baobuibk/NANORACK_V2_EXP_1.1.1_HW/02_Schematic_pdf/EXP_HW_V120.pdf

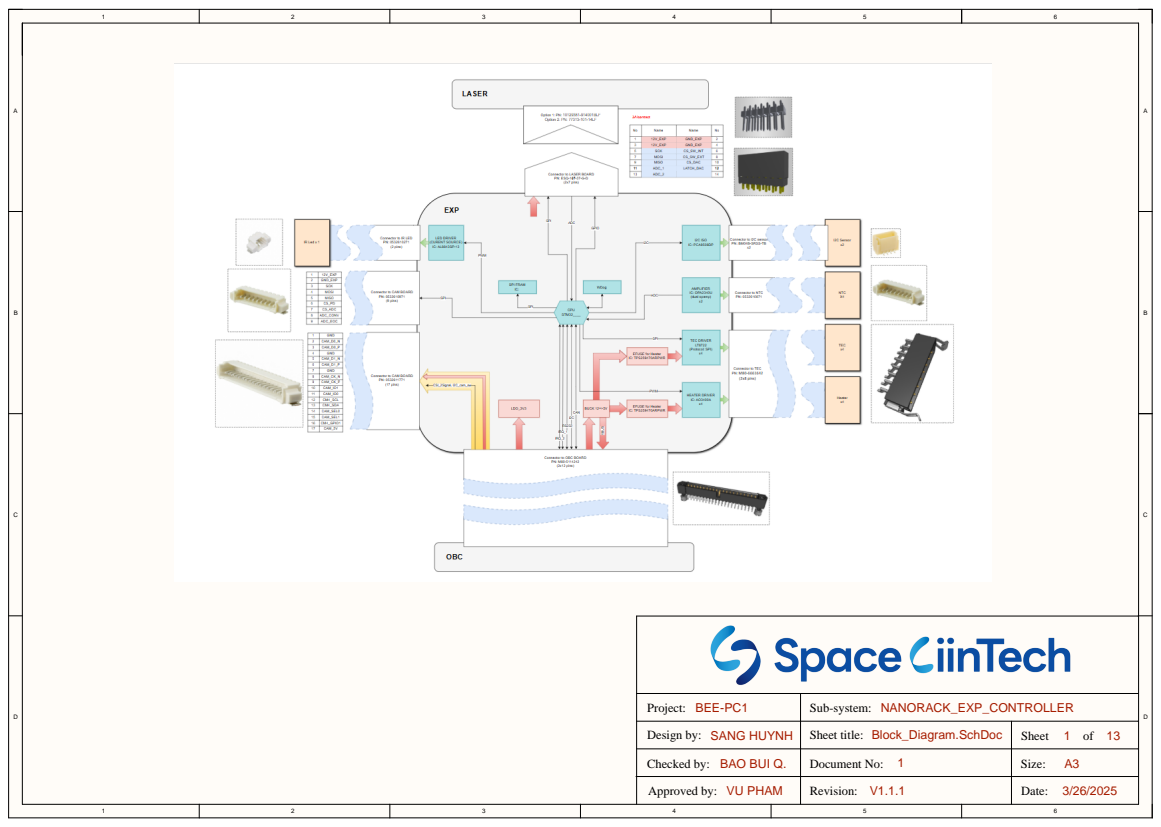
[picture p1: page 1]

Project: BEE-PC1 | Sub-system: NANORACK_EXP_CONTROLLER

Design by: SANG HUYNH | Sheet title: Block_Diagram.SchDoc | Sheet 1 of 13

Checked by: BAO BUI Q. | Document No: 1 | Size: A3

Approved by: VU PHAM | Revision: V1.1.1 | Date: 3/26/2025

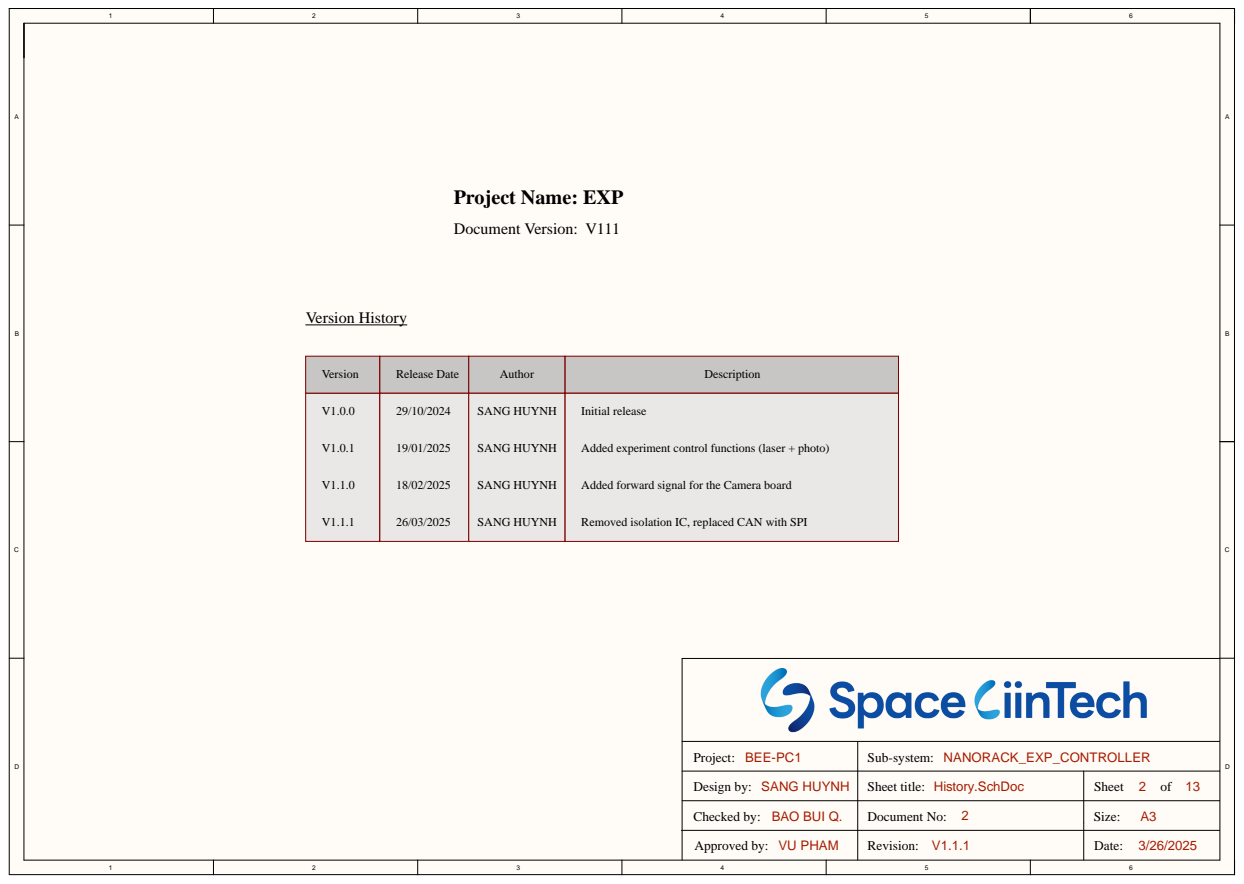
[picture p2: page 2]

Version | Release Date | Author | Description

V1.0.0 V1.0.1 V1.1.0 V1.1.1 | 29/10/2024 19/01/2025 18/02/2025 26/03/2025 | SANG HUYNH SANG HUYNH | Initial release Added experiment control functions (laser + photo) Added forward signal for the Camera board Removed isolation IC, replaced CAN with SPI

Project: BEE-PC1 | Sub-system: NANORACK_EXP_CONTROLLER

Design by: SANG HUYNH | Sheet title: History.SchDoc | Sheet 2 of 13

Checked by: BAO BUI Q. | Document No: 2 | Size: A3

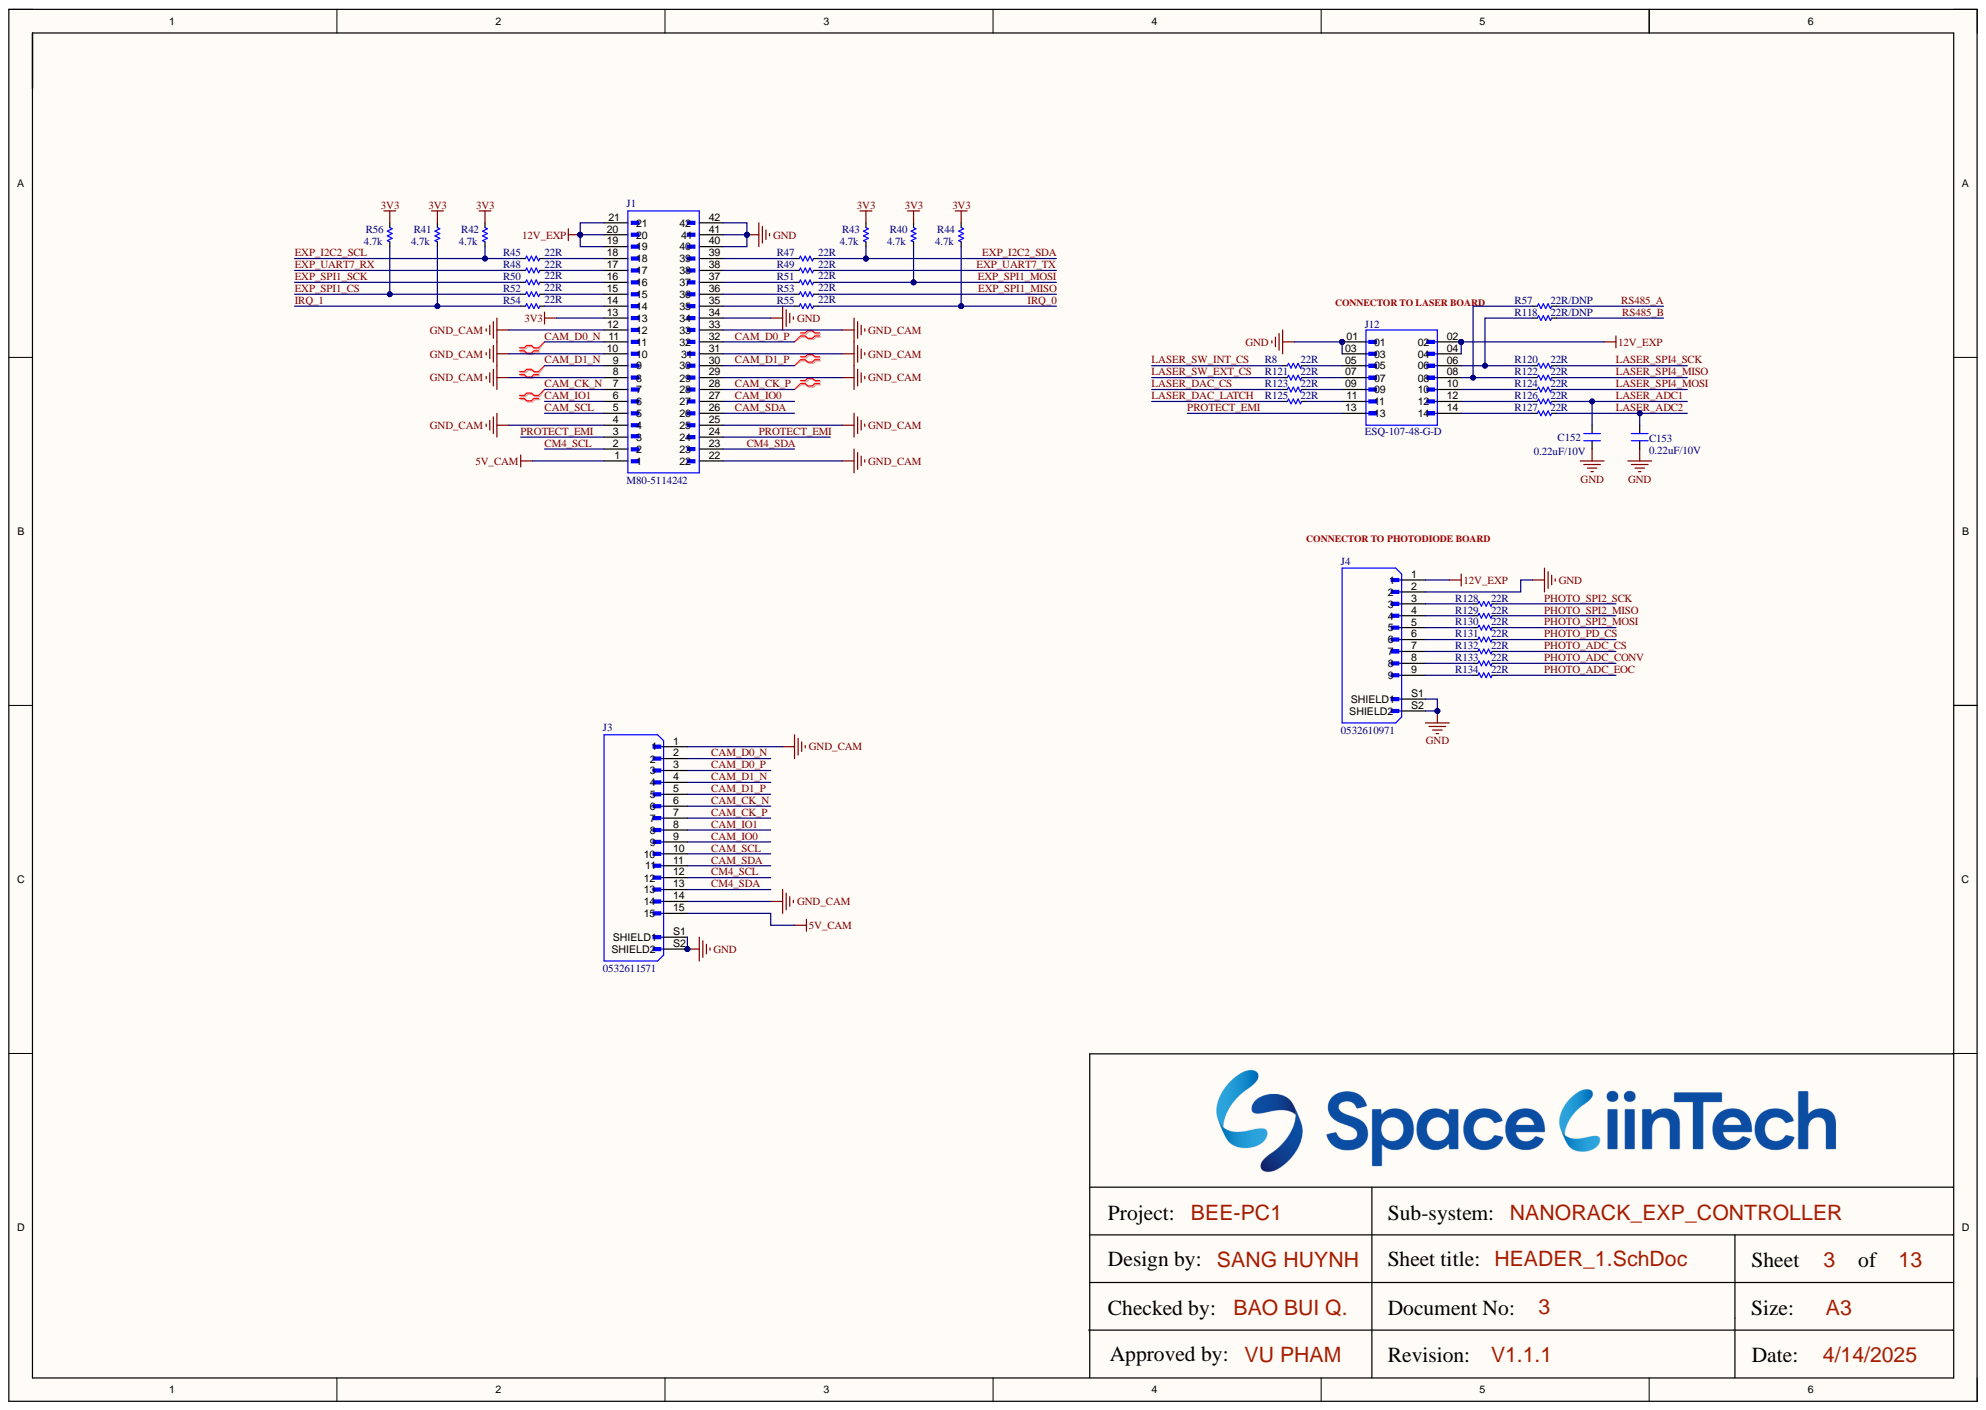
[picture p3: page 3]

CONNECTOR TO LASER BOARD

CONNECTOR TO PHOTODIODE BOARD

Project: BEE-PC1 | Sub-system: NANORACK_EXP_CONTROLLER

Design by: SANG HUYNH | Sheet title: HEADER_1.SchDoc | Sheet 3 of 13

Checked by: BAO BUI Q. | Document No: 3 | Size: A3

Date: 4/14/2025

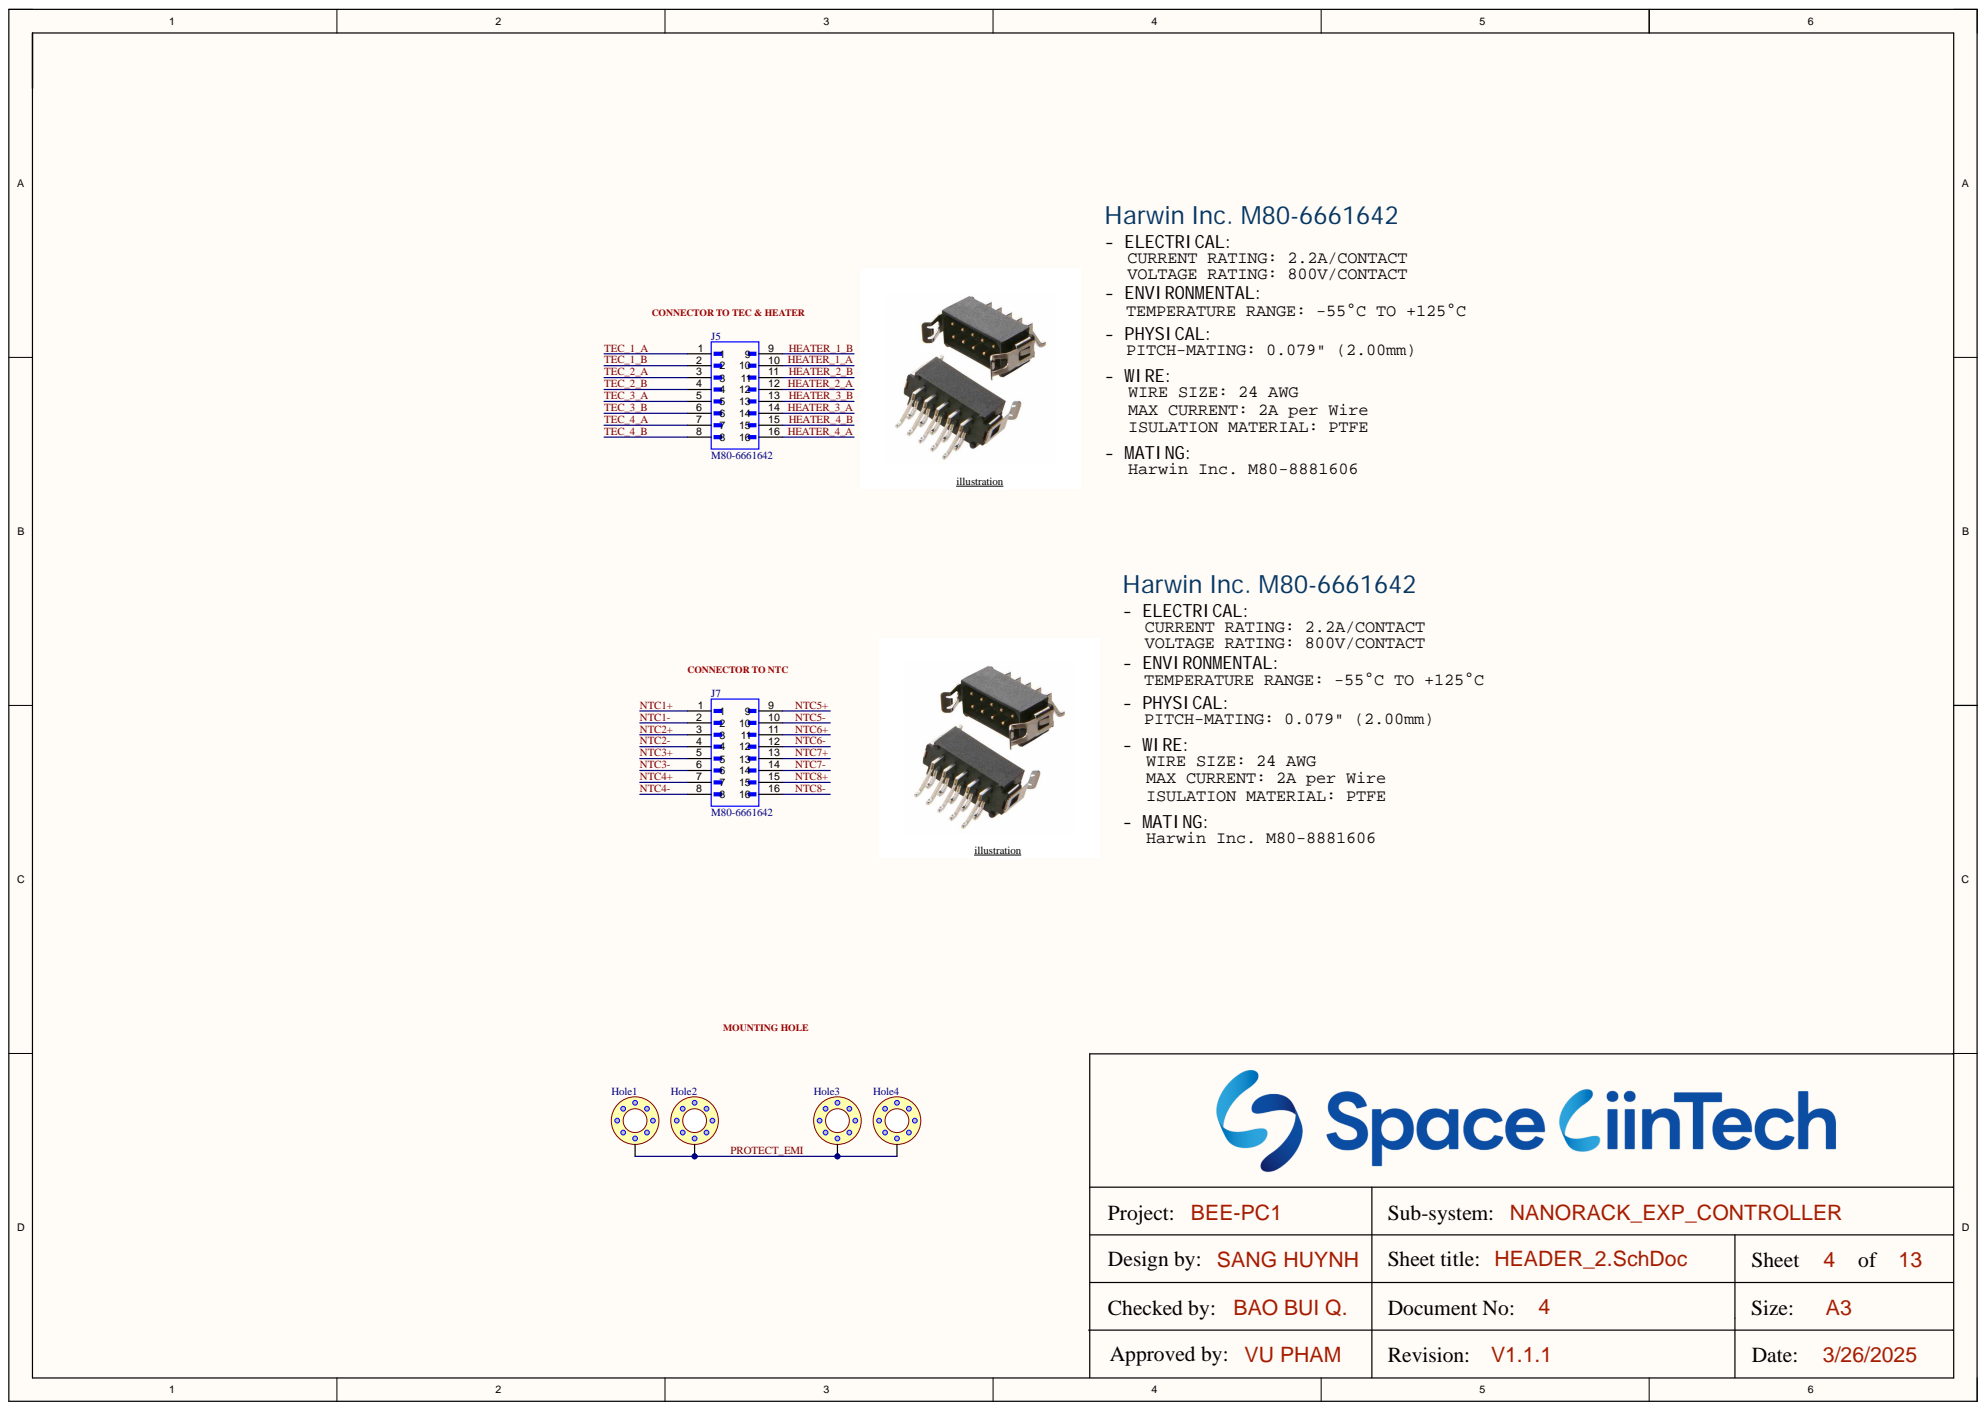
[picture p4: page 4]

- ELECTRICAL: CURRENT RATING: 2.2A/CONTACT VOLTAGE RATING: 800V/CONTACT

- ENVIRONMENTAL: TEMPERATURE RANGE: -55°C TO +125°C

CONNECTOR TO TEC & HEATER

- WIRE:
WIRE SIZE: 24 AWG
MAX CURRENT: 2A per Wire
ISULATION MATERIAL: PTFE
- MATING:
Harwin Inc. M80-8881606

Project: BEE-PC1 | Sub-system: NANORACK_EXP_CONTROLLER

Design by: SANG HUYNH | Sheet title: HEADER_2.SchDoc | Sheet 4 of 13

Checked by: BAO BUI Q. | Document No: 4 | Size: A3

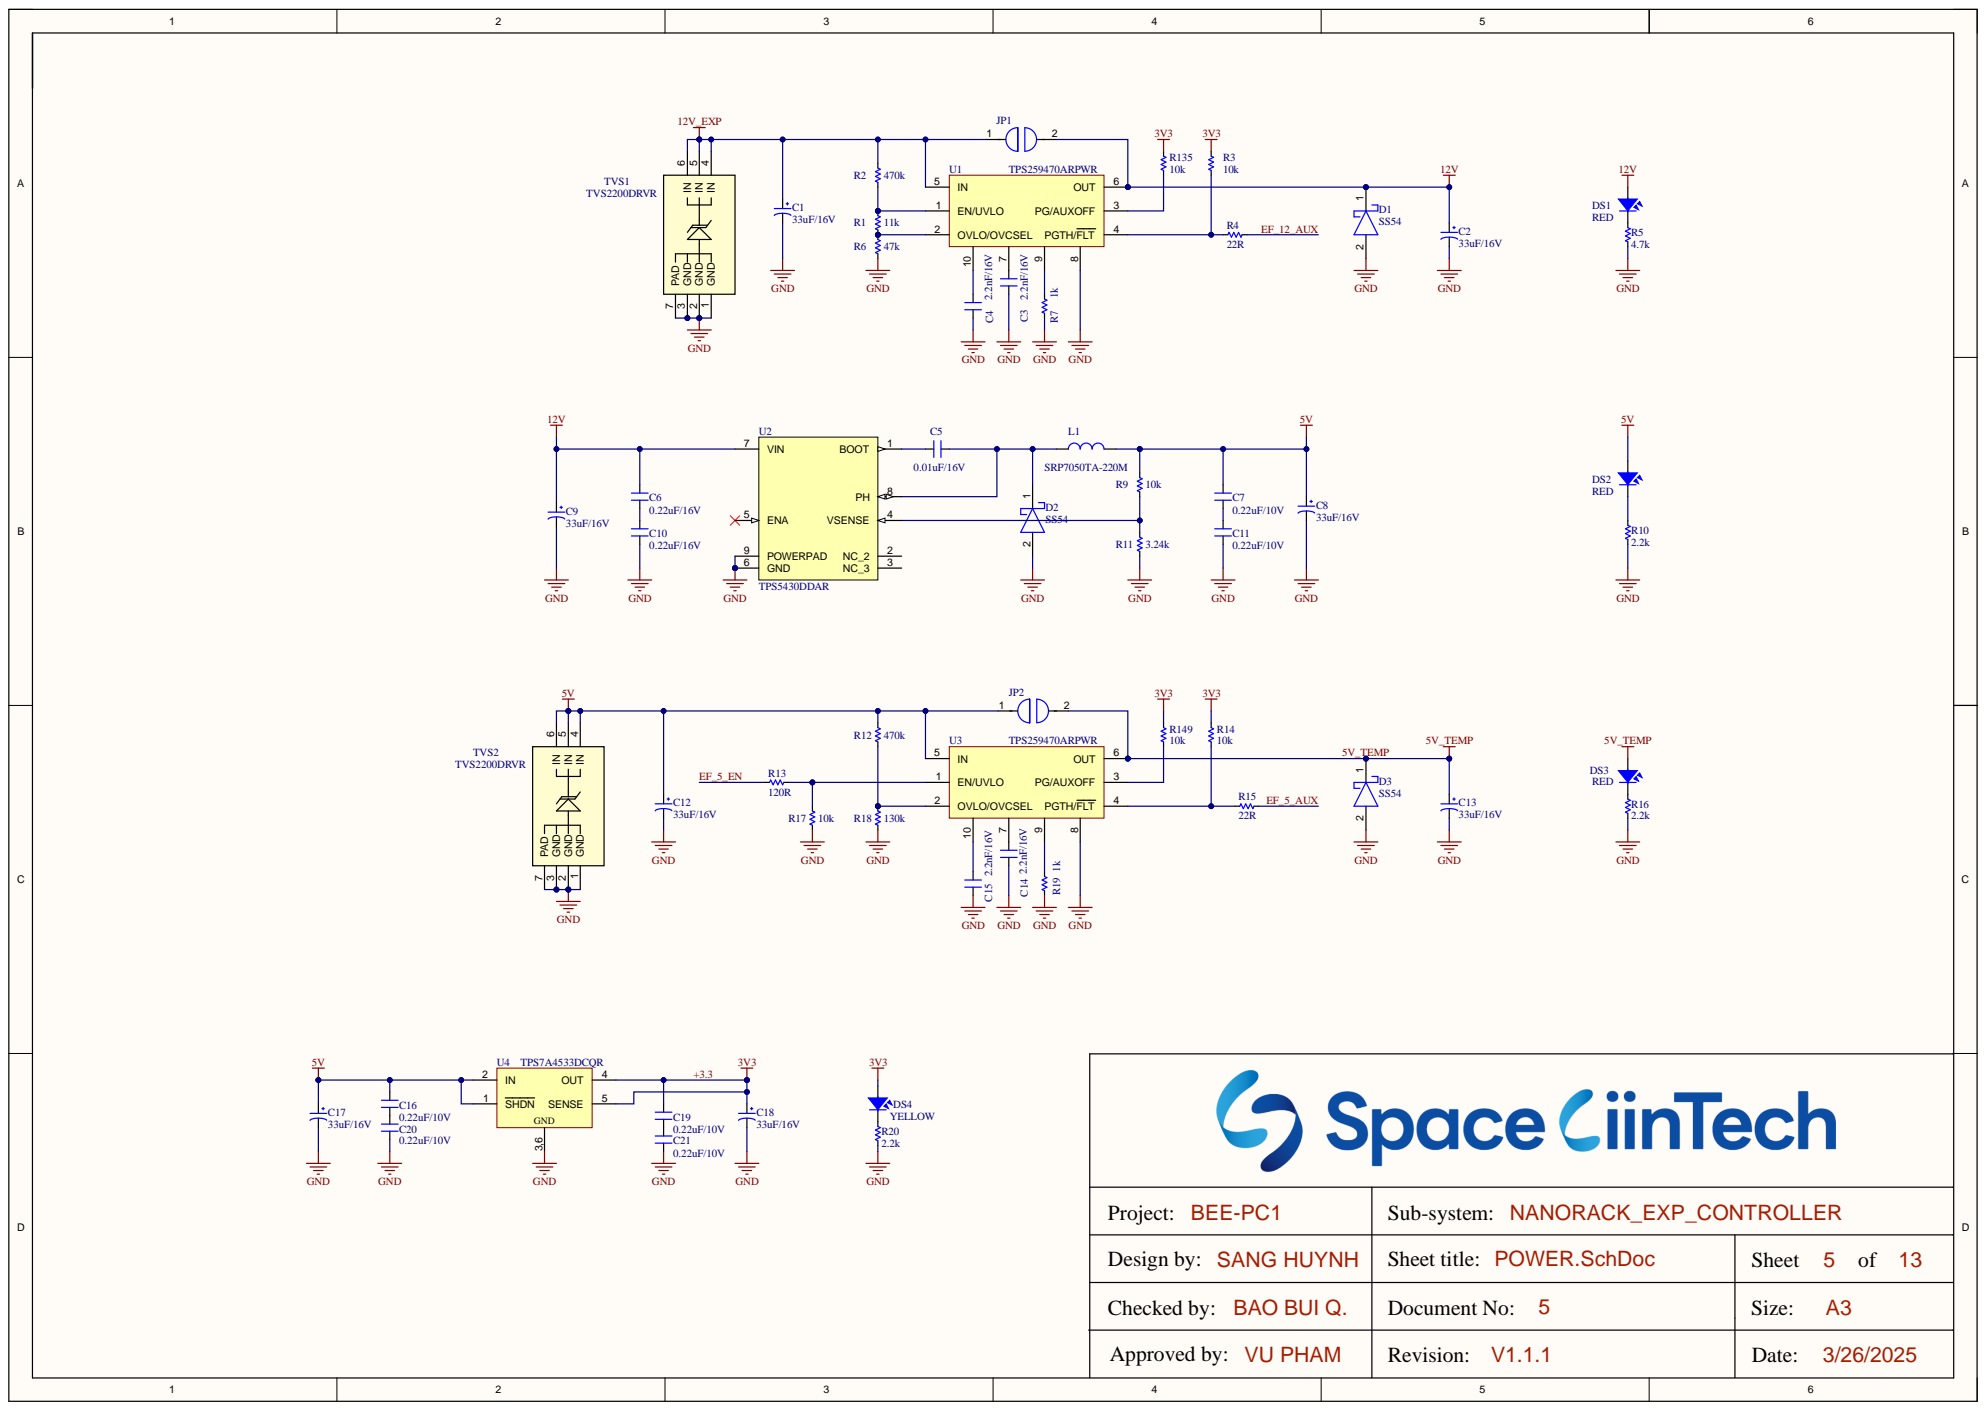
[picture p5: page 5]

IN 4 IN 5 IN 6 PAD 7

Project: BEE-PC1 | Sub-system: NANORACK_EXP_CONTROLLER

Design by: SANG HUYNH | Sheet title: POWER.SchDoc | Sheet 5 of 13

Checked by: BAO BUI Q. | Document No: 5 | Size: A3

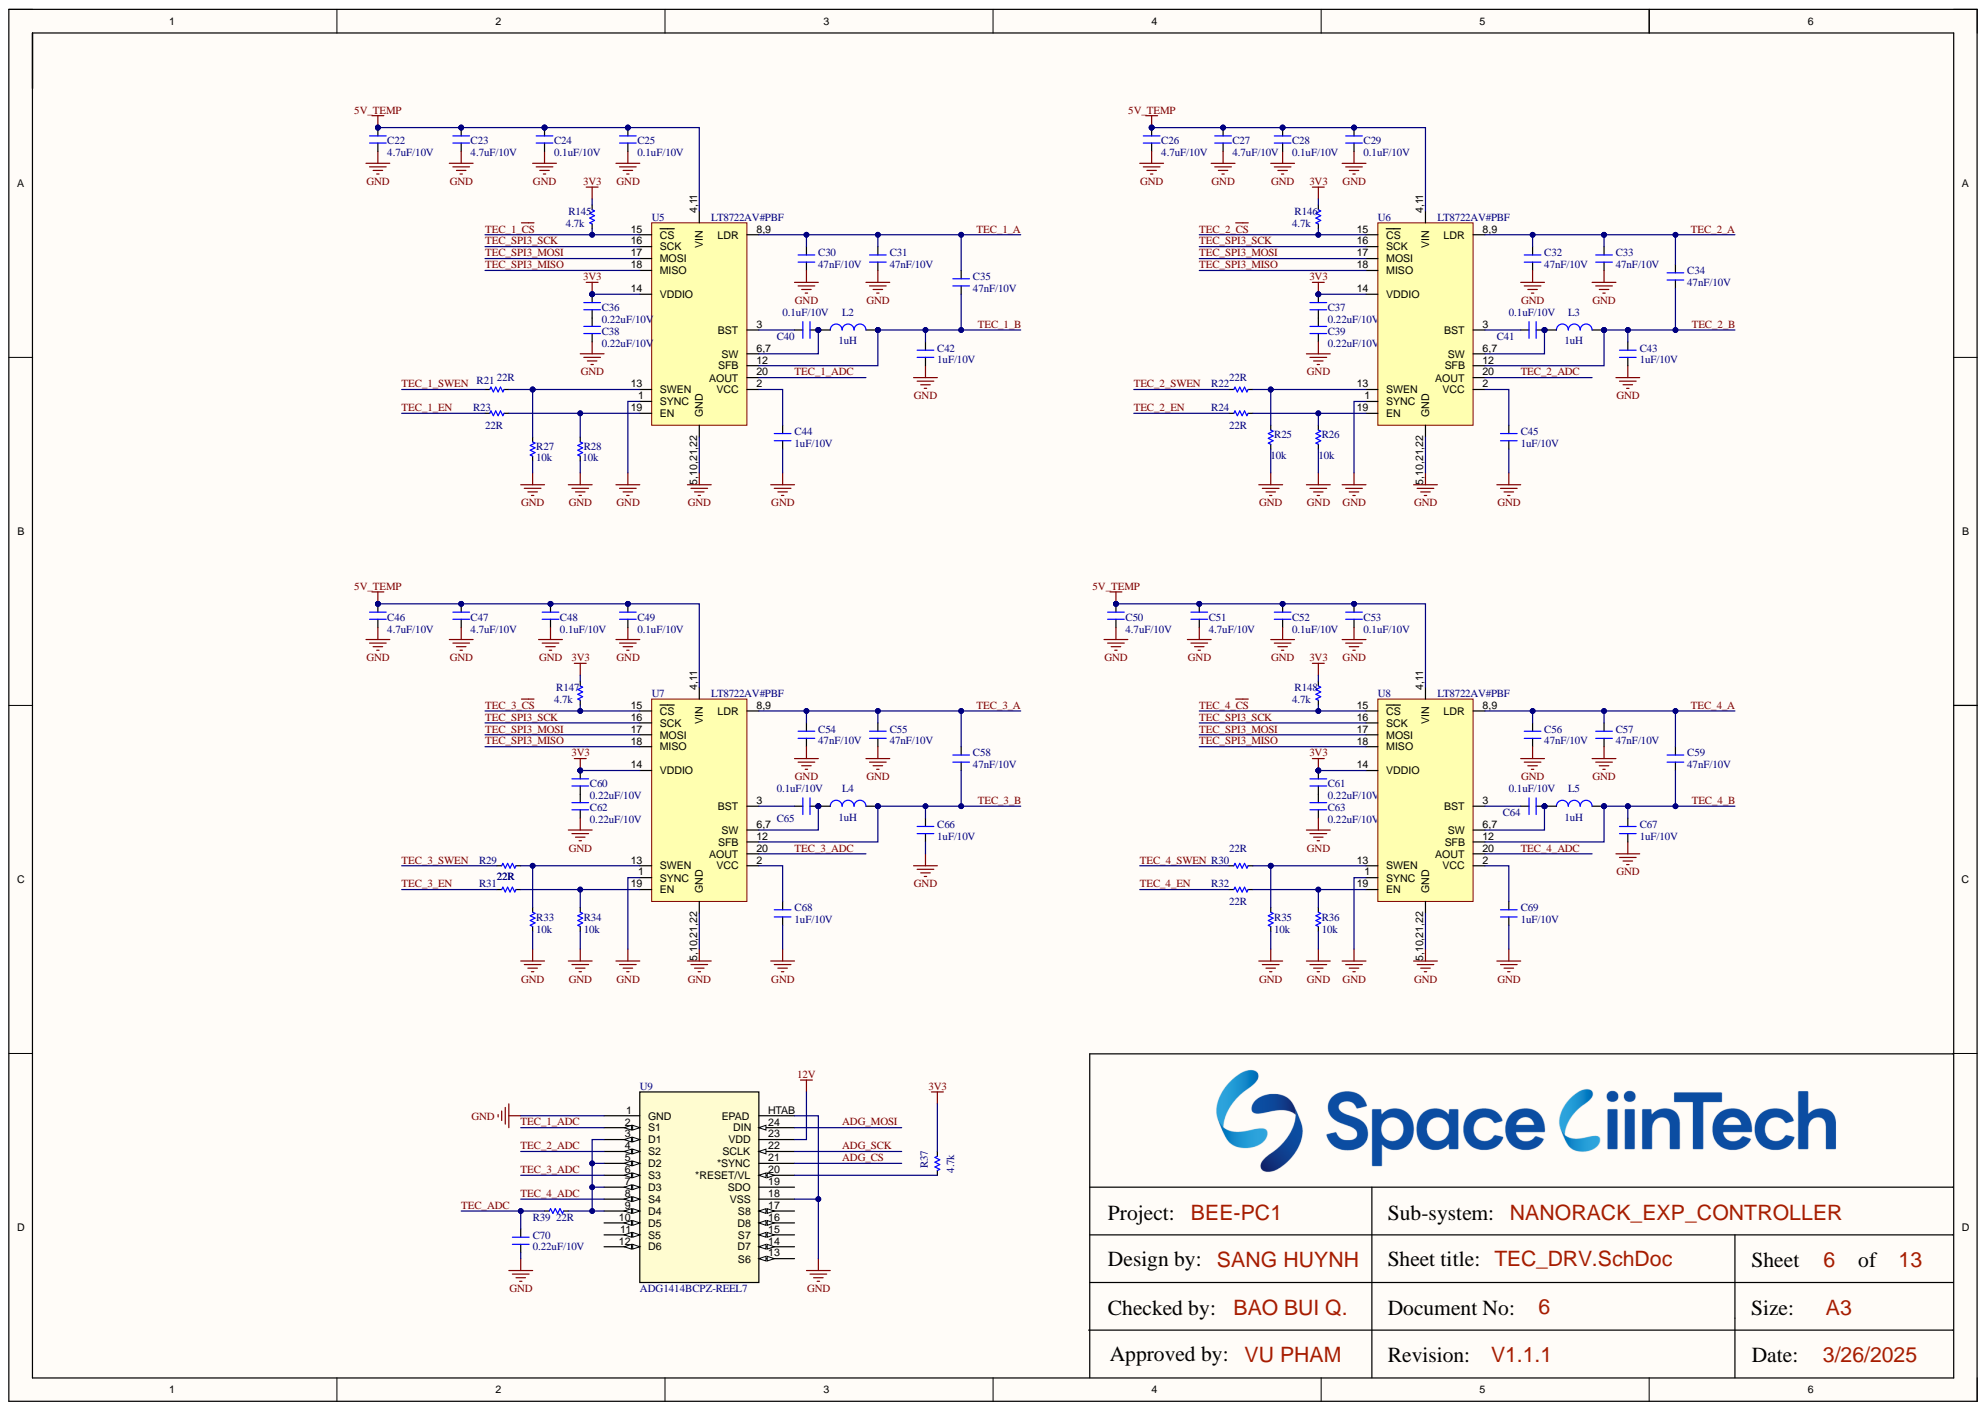
[picture p6: page 6]

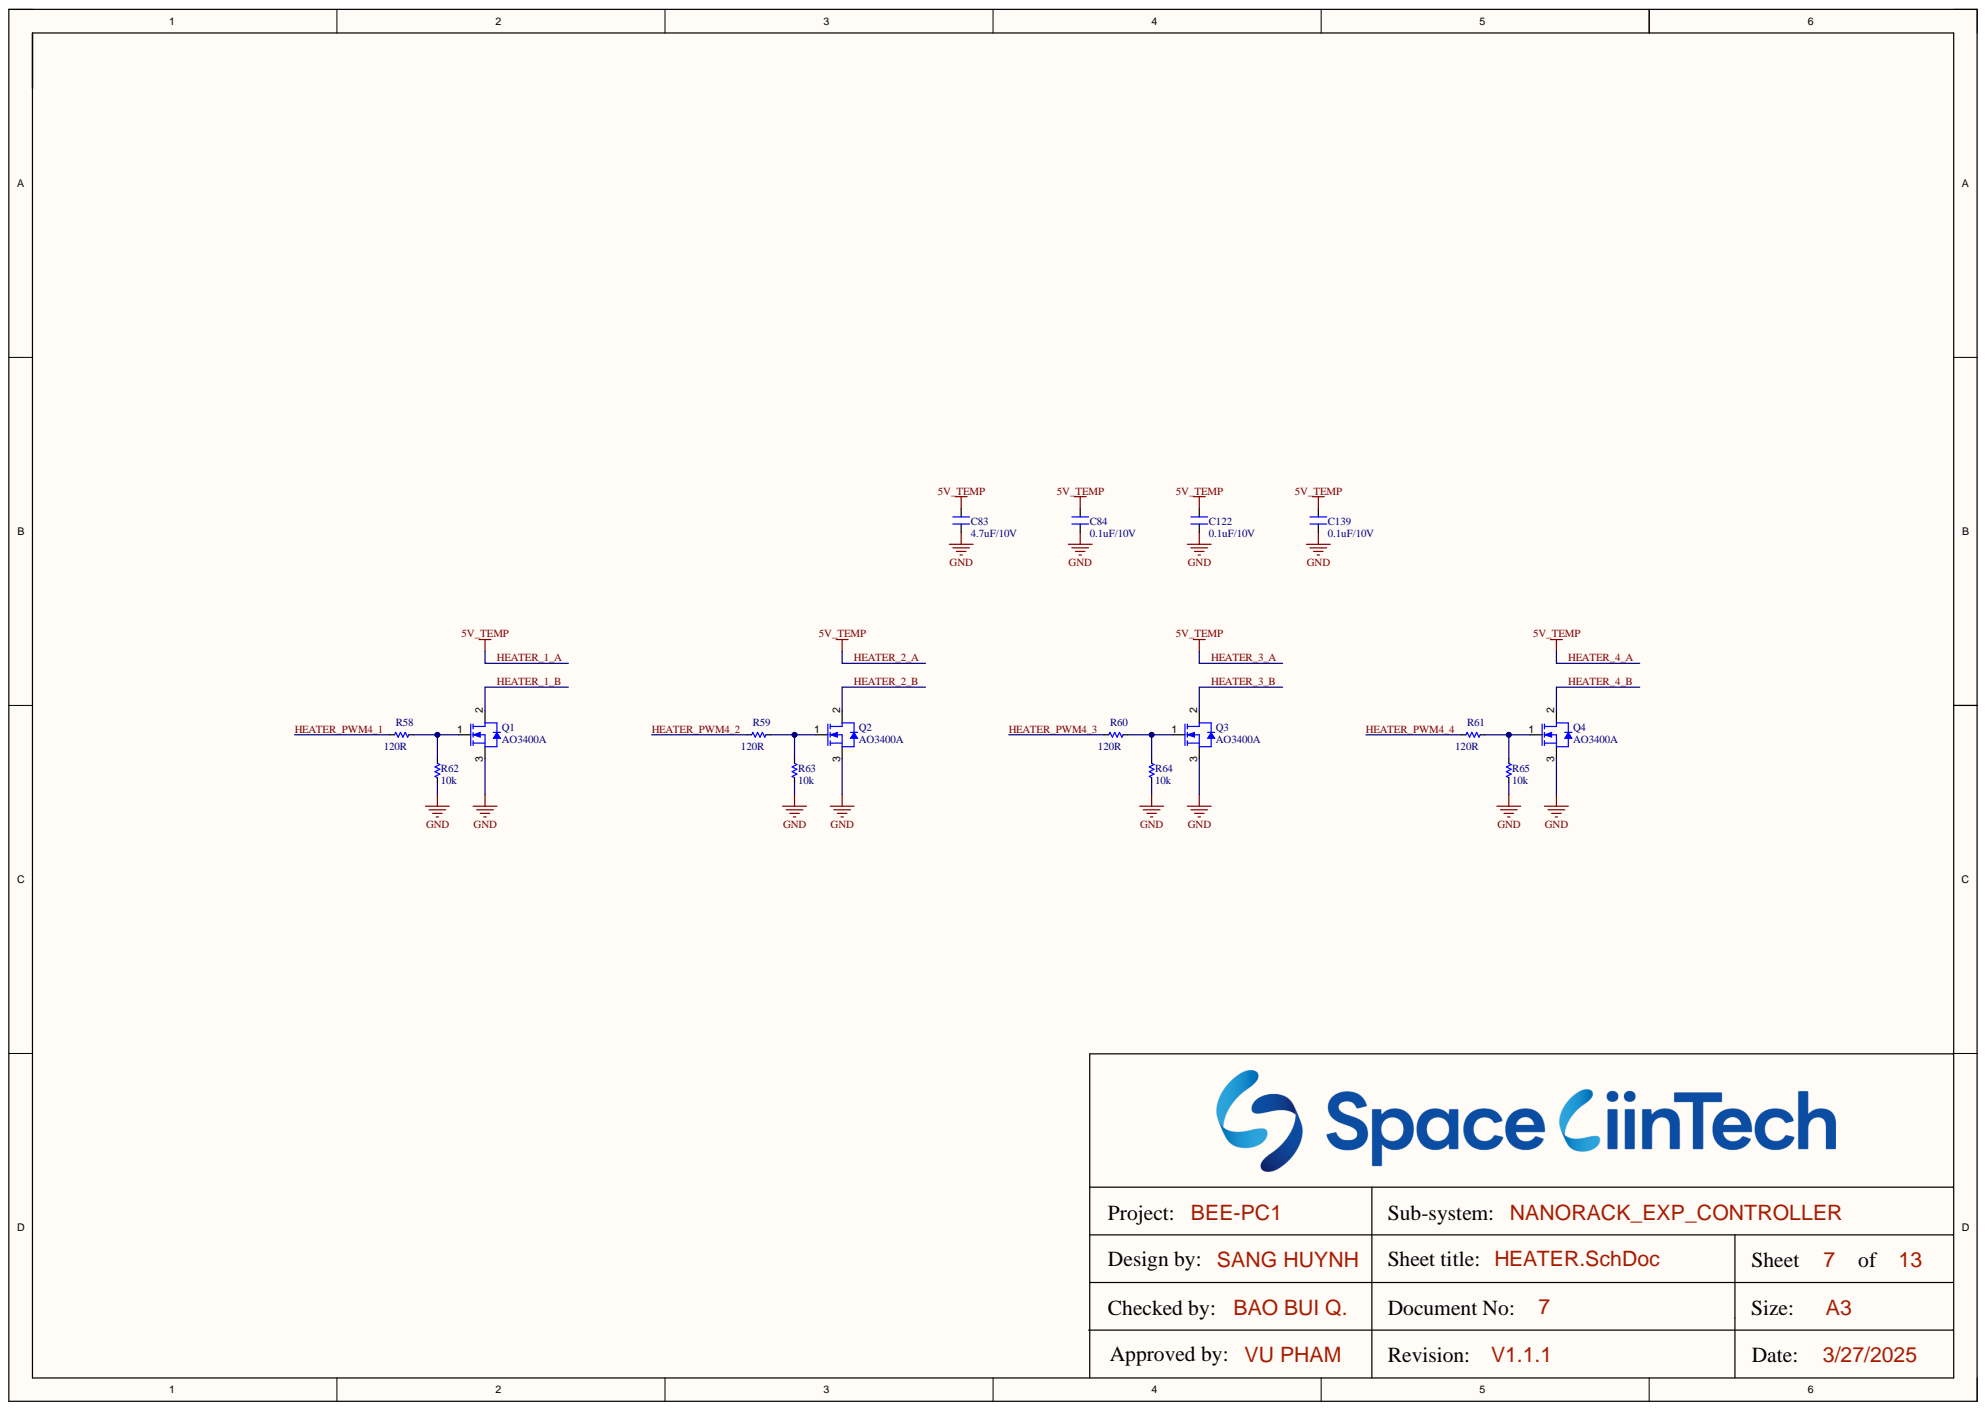
[picture p7: page 7]

Project: BEE-PC1 | Sub-system: NANORACK_EXP_CONTROLLER

Design by: SANG HUYNH | Sheet title: HEATER.SchDoc | Sheet 7 of 13

Checked by: BAO BUI Q. | Document No: 7 | Size: A3

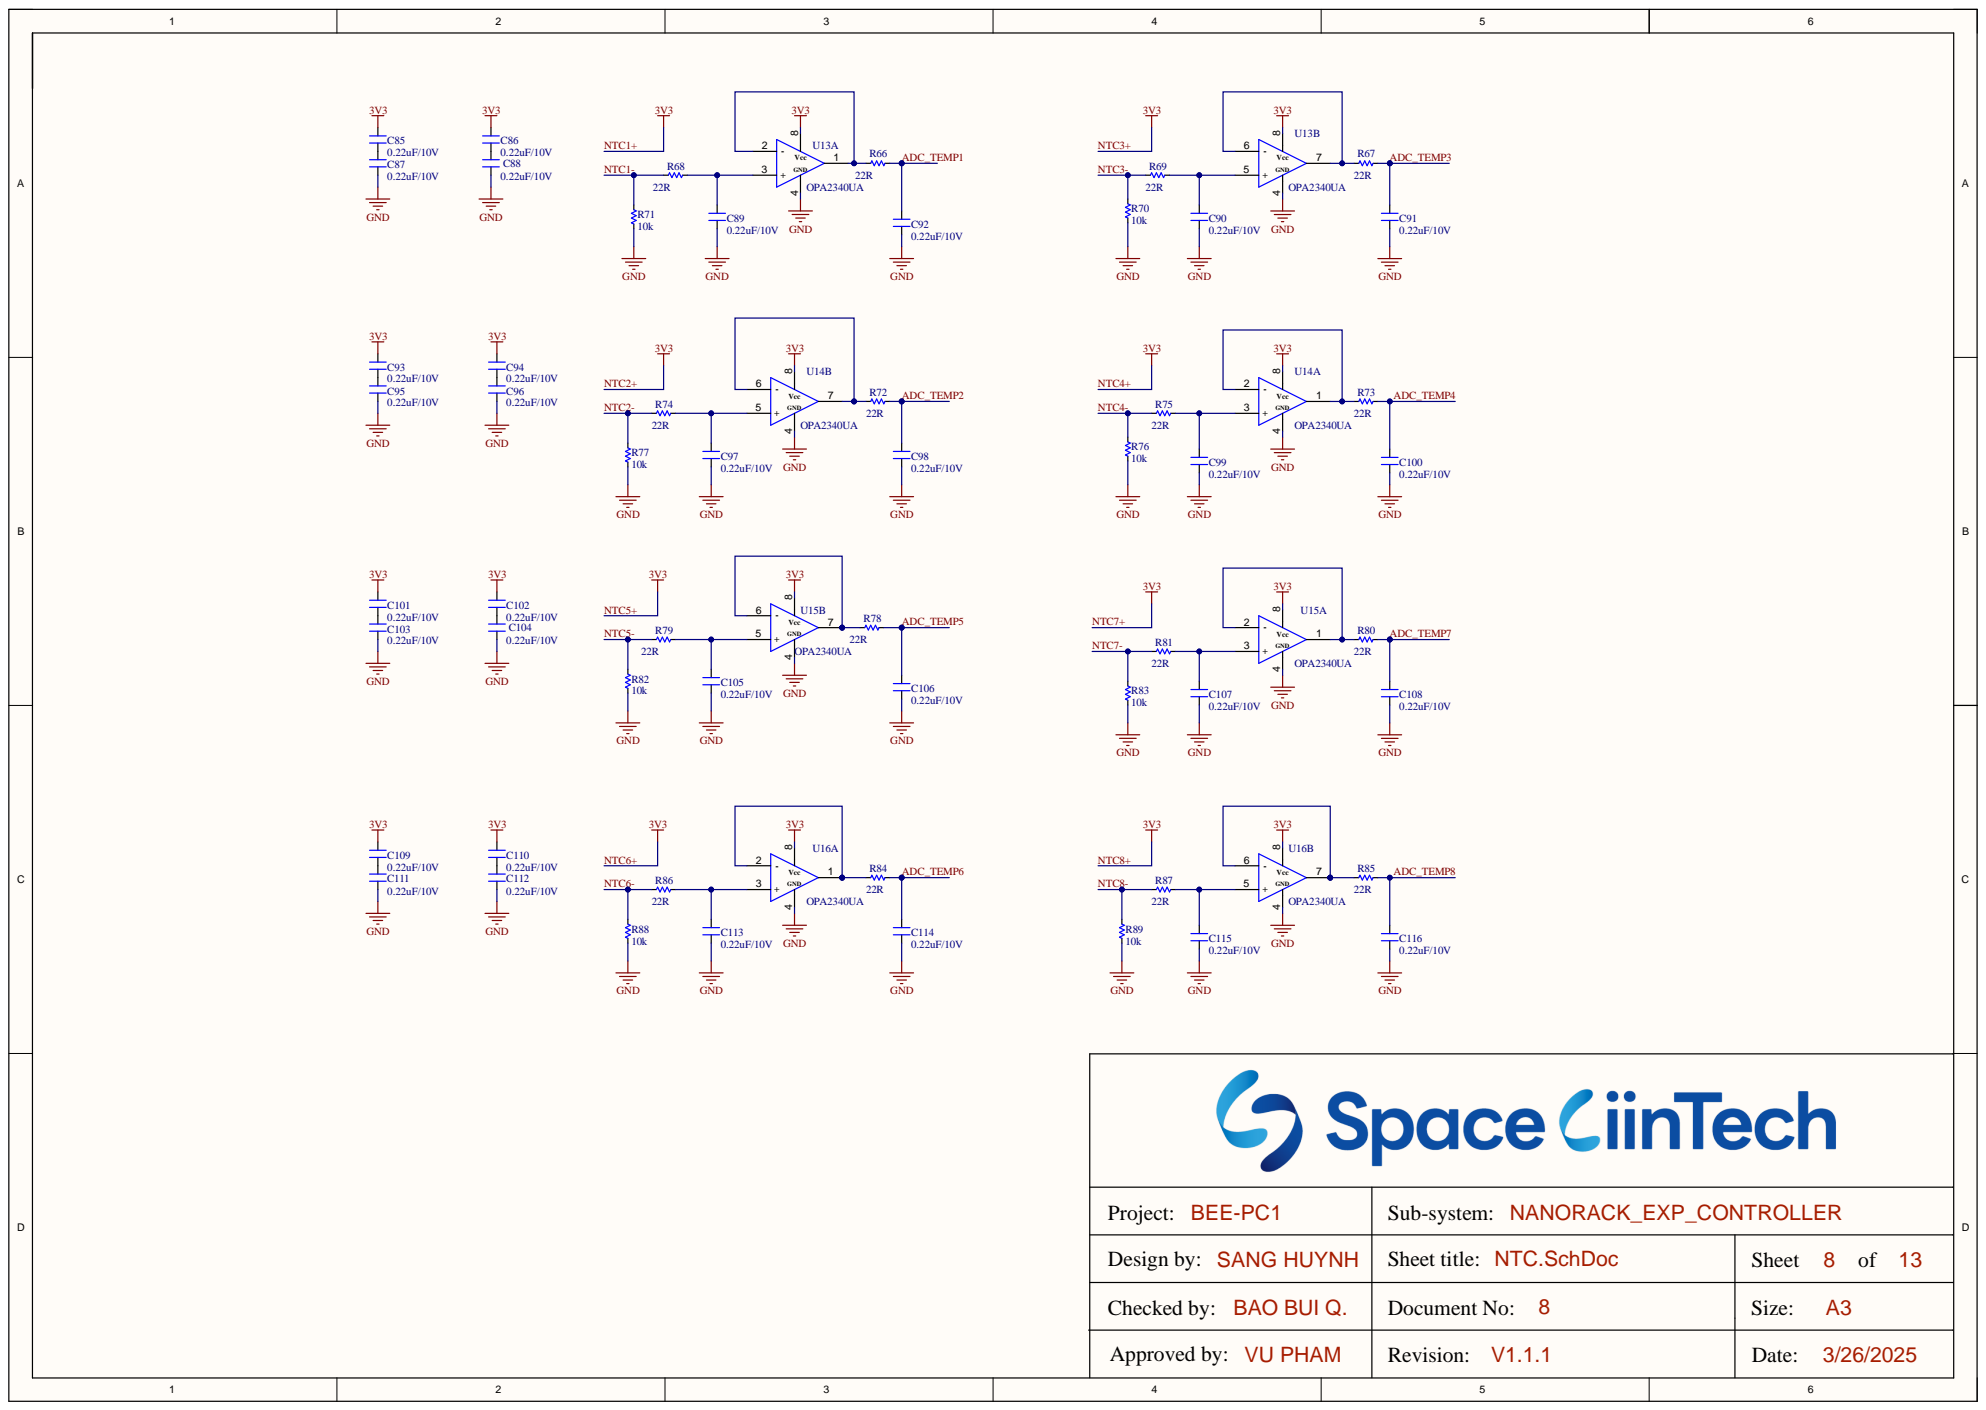
[picture p8: page 8]

Project: BEE-PC1 | Sub-system: NANORACK_EXP_CONTROLLER

Design by: SANG HUYNH | Sheet title: NTC.SchDoc | Sheet 8 of 13

Checked by: BAO BUI Q. | Document No: 8 | Size: A3

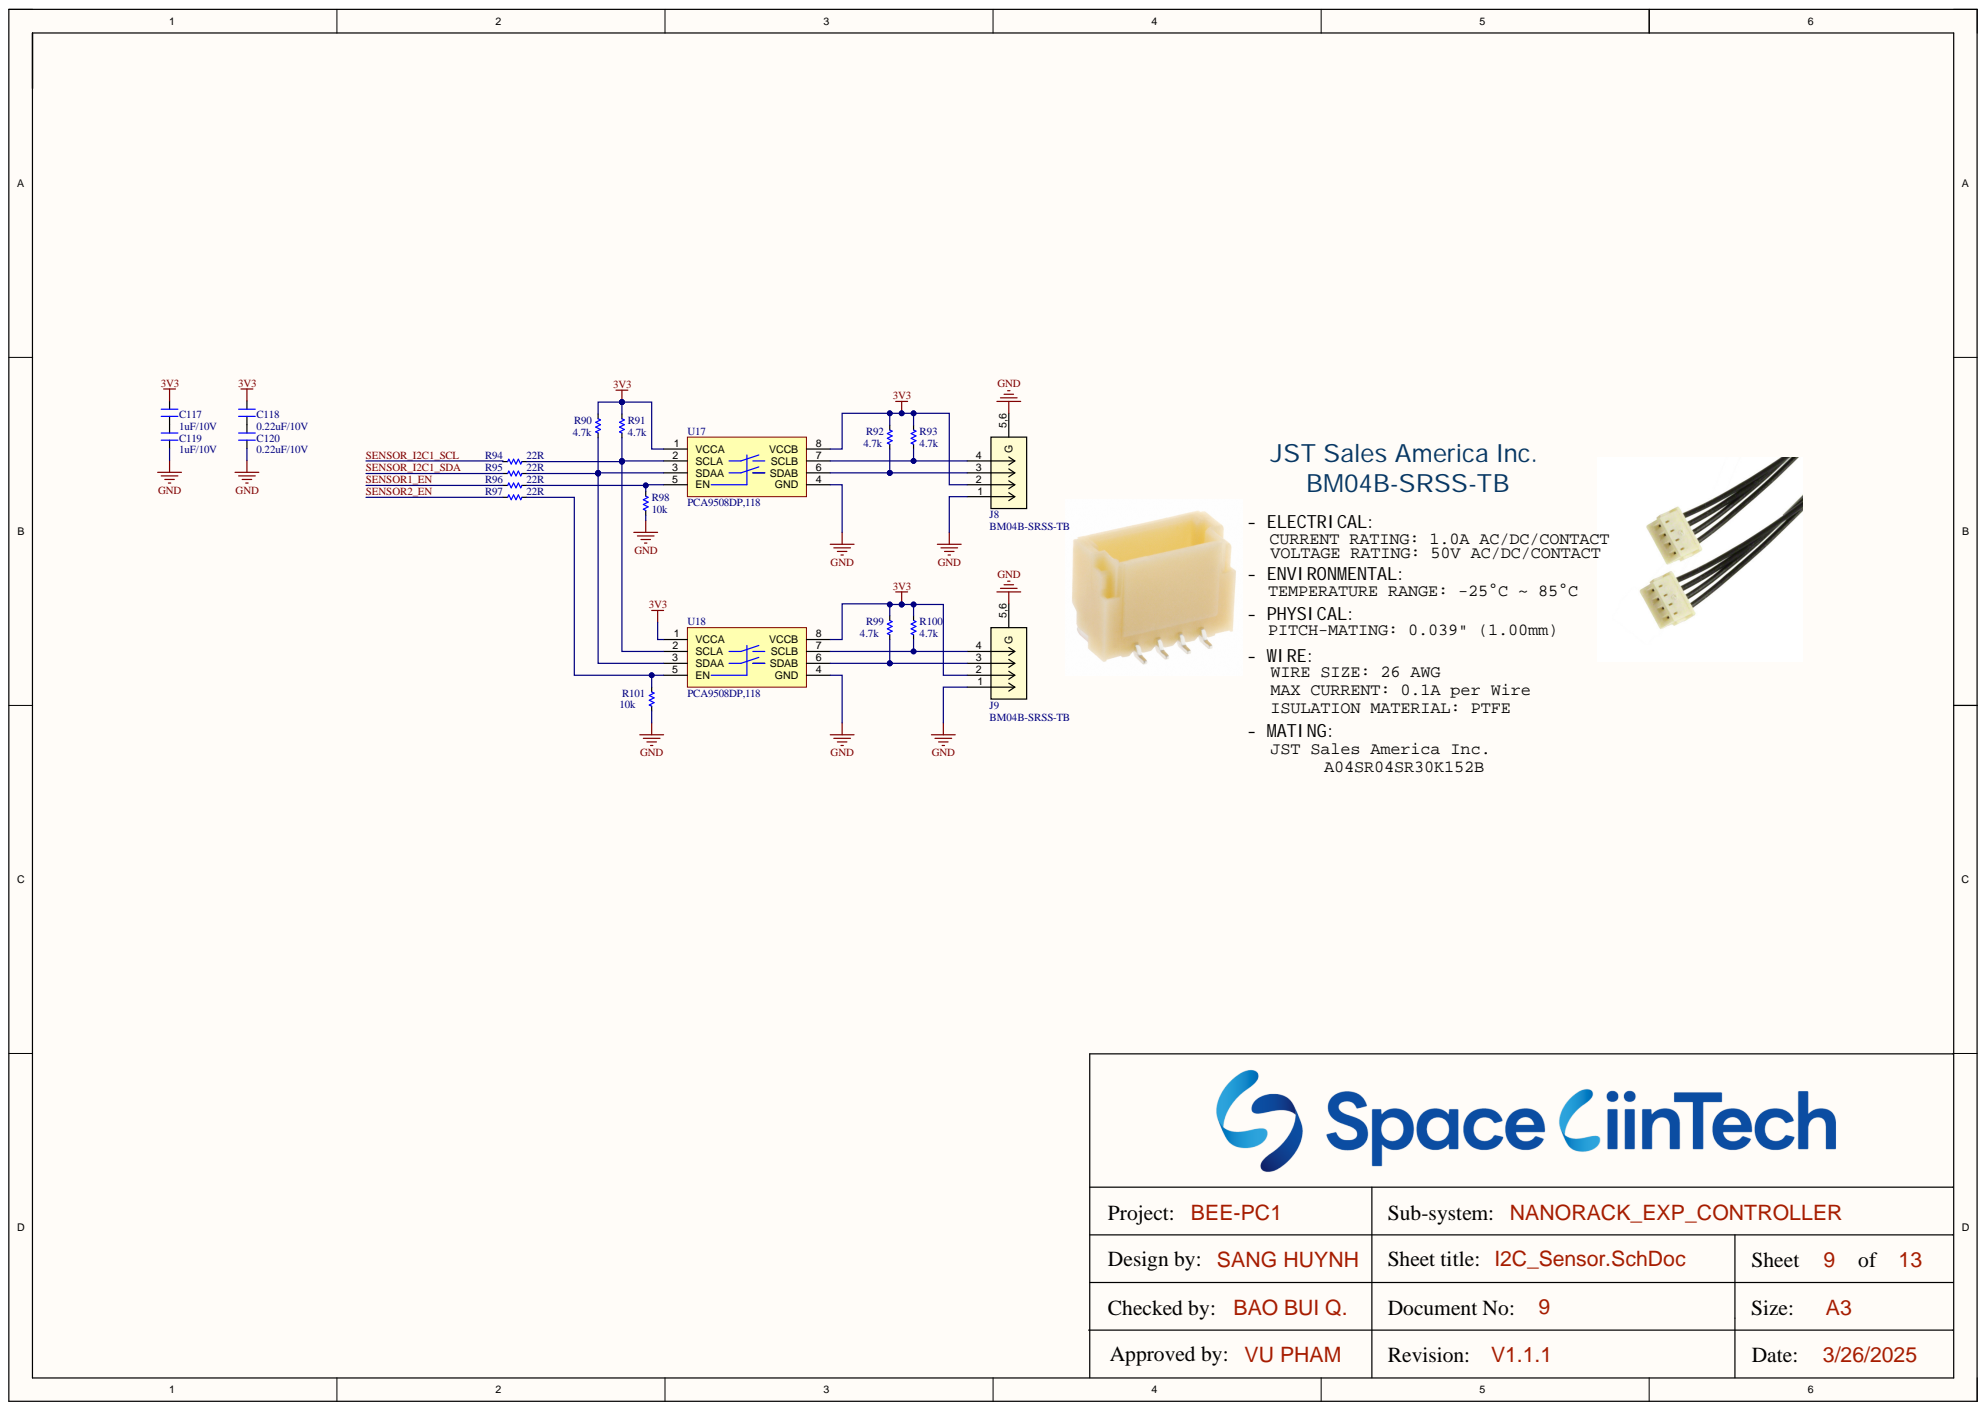
[picture p9: page 9]

Project : BEE-PC1 | Sub-system : NANORACK_EXP_CONTROLLER

Design by: SANG HUYNH | Sheet title: I2C_Sensor.SchDoc | Sheet 9 of 13

Checked by: BAO BUI Q. | Document No: V1.1.19 | Size: A3

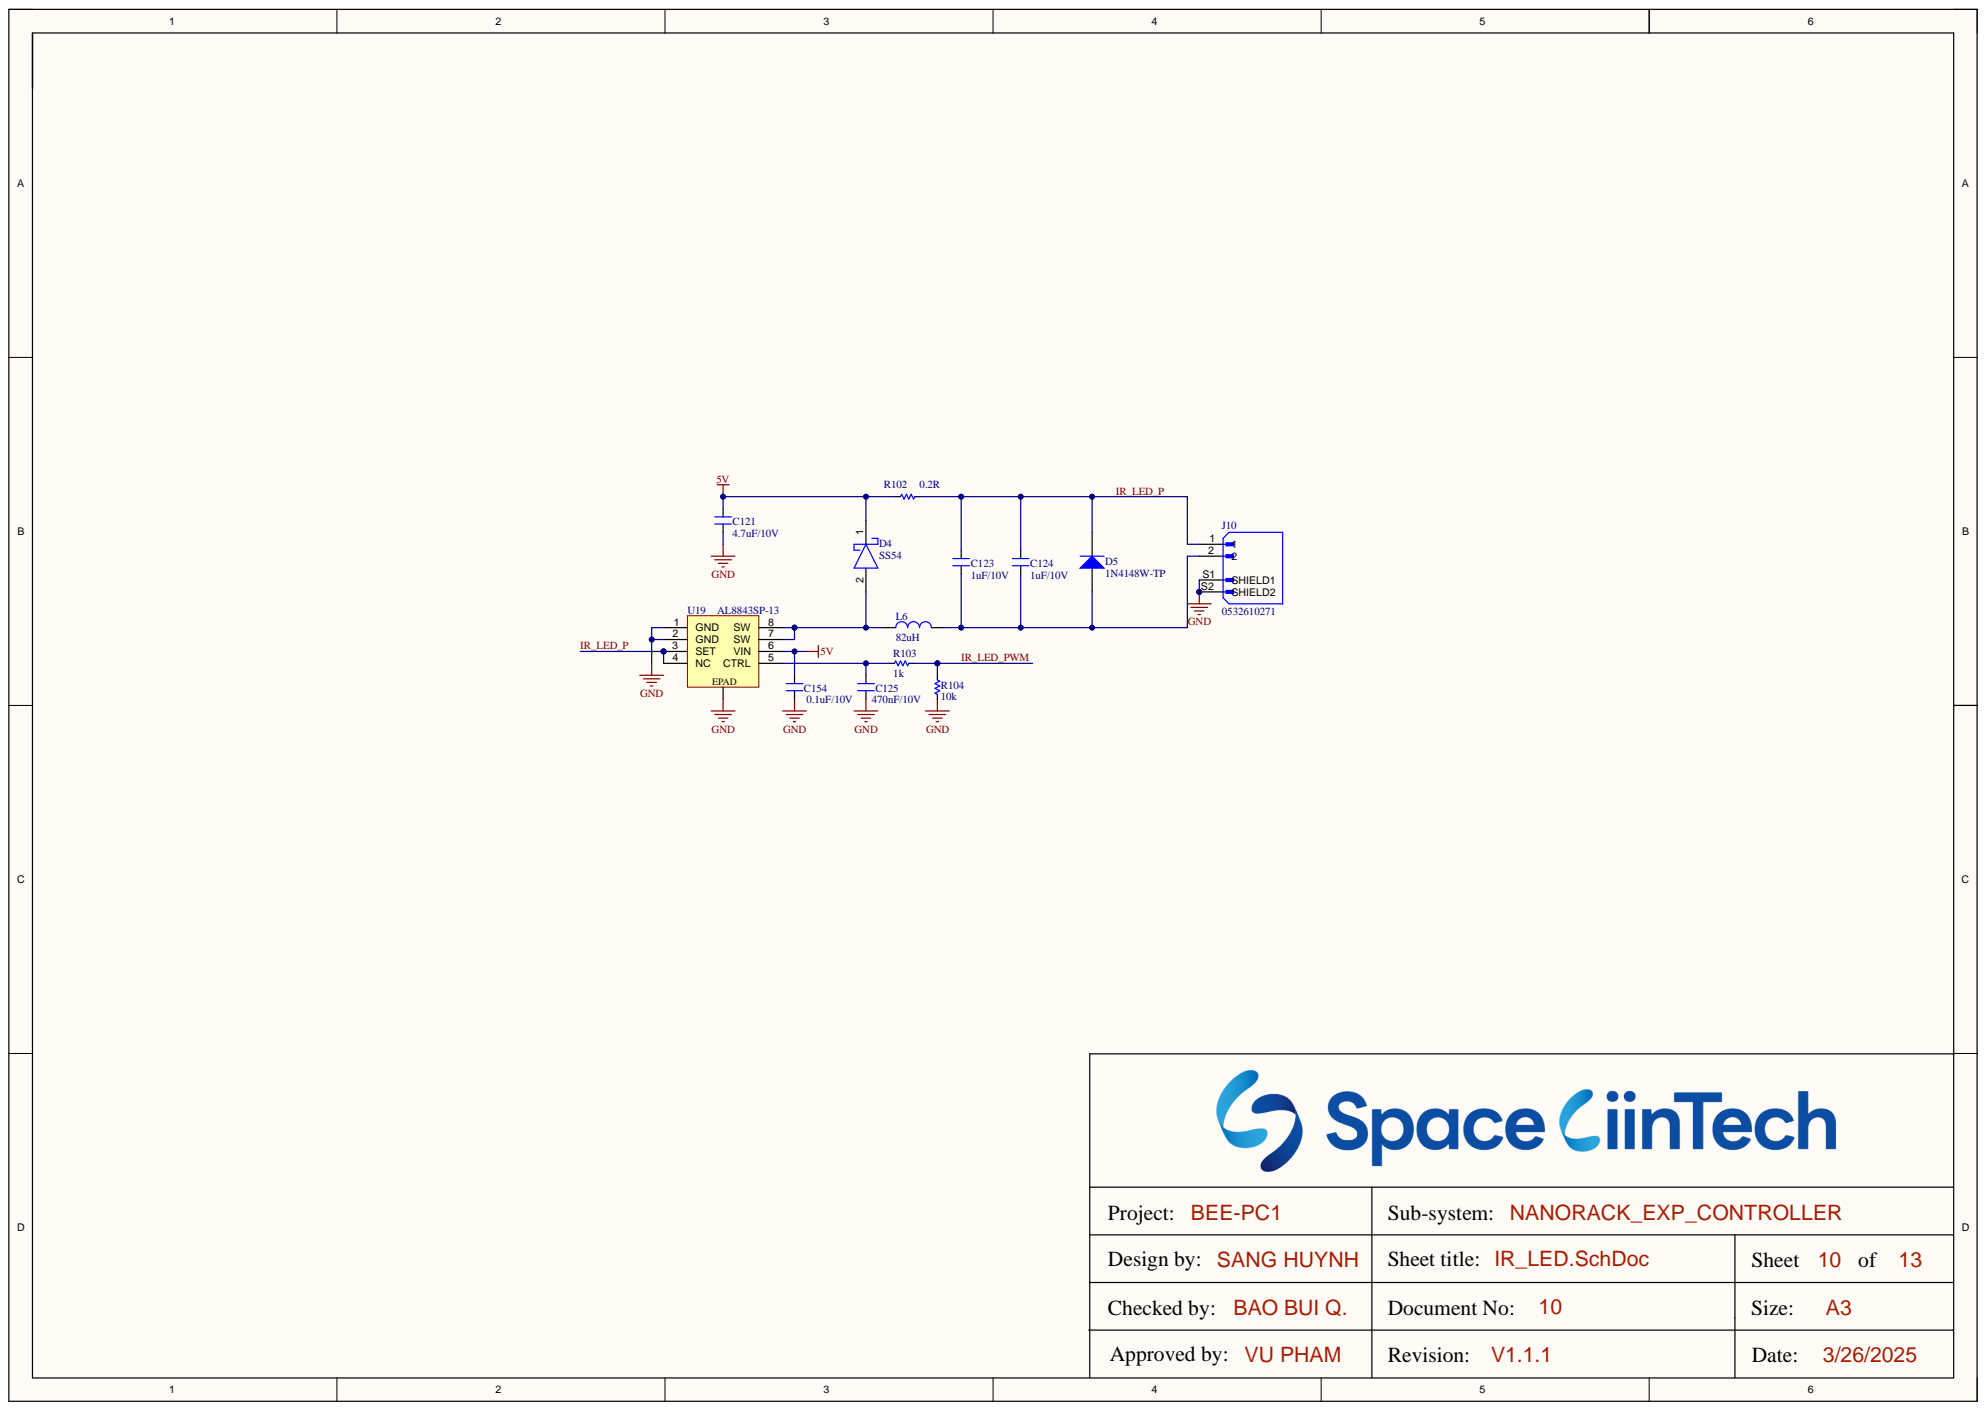
[picture p10: page 10]

Project : BEE-PC1 | Sub-system : NANORACK_EXP_CONTROLLER

Design by: SANG HUYNH | Sheet title: IR_LED.SchDoc | Sheet 10 of 13

Checked by: BAO BUI Q. | Document No: 10 | Size: A3

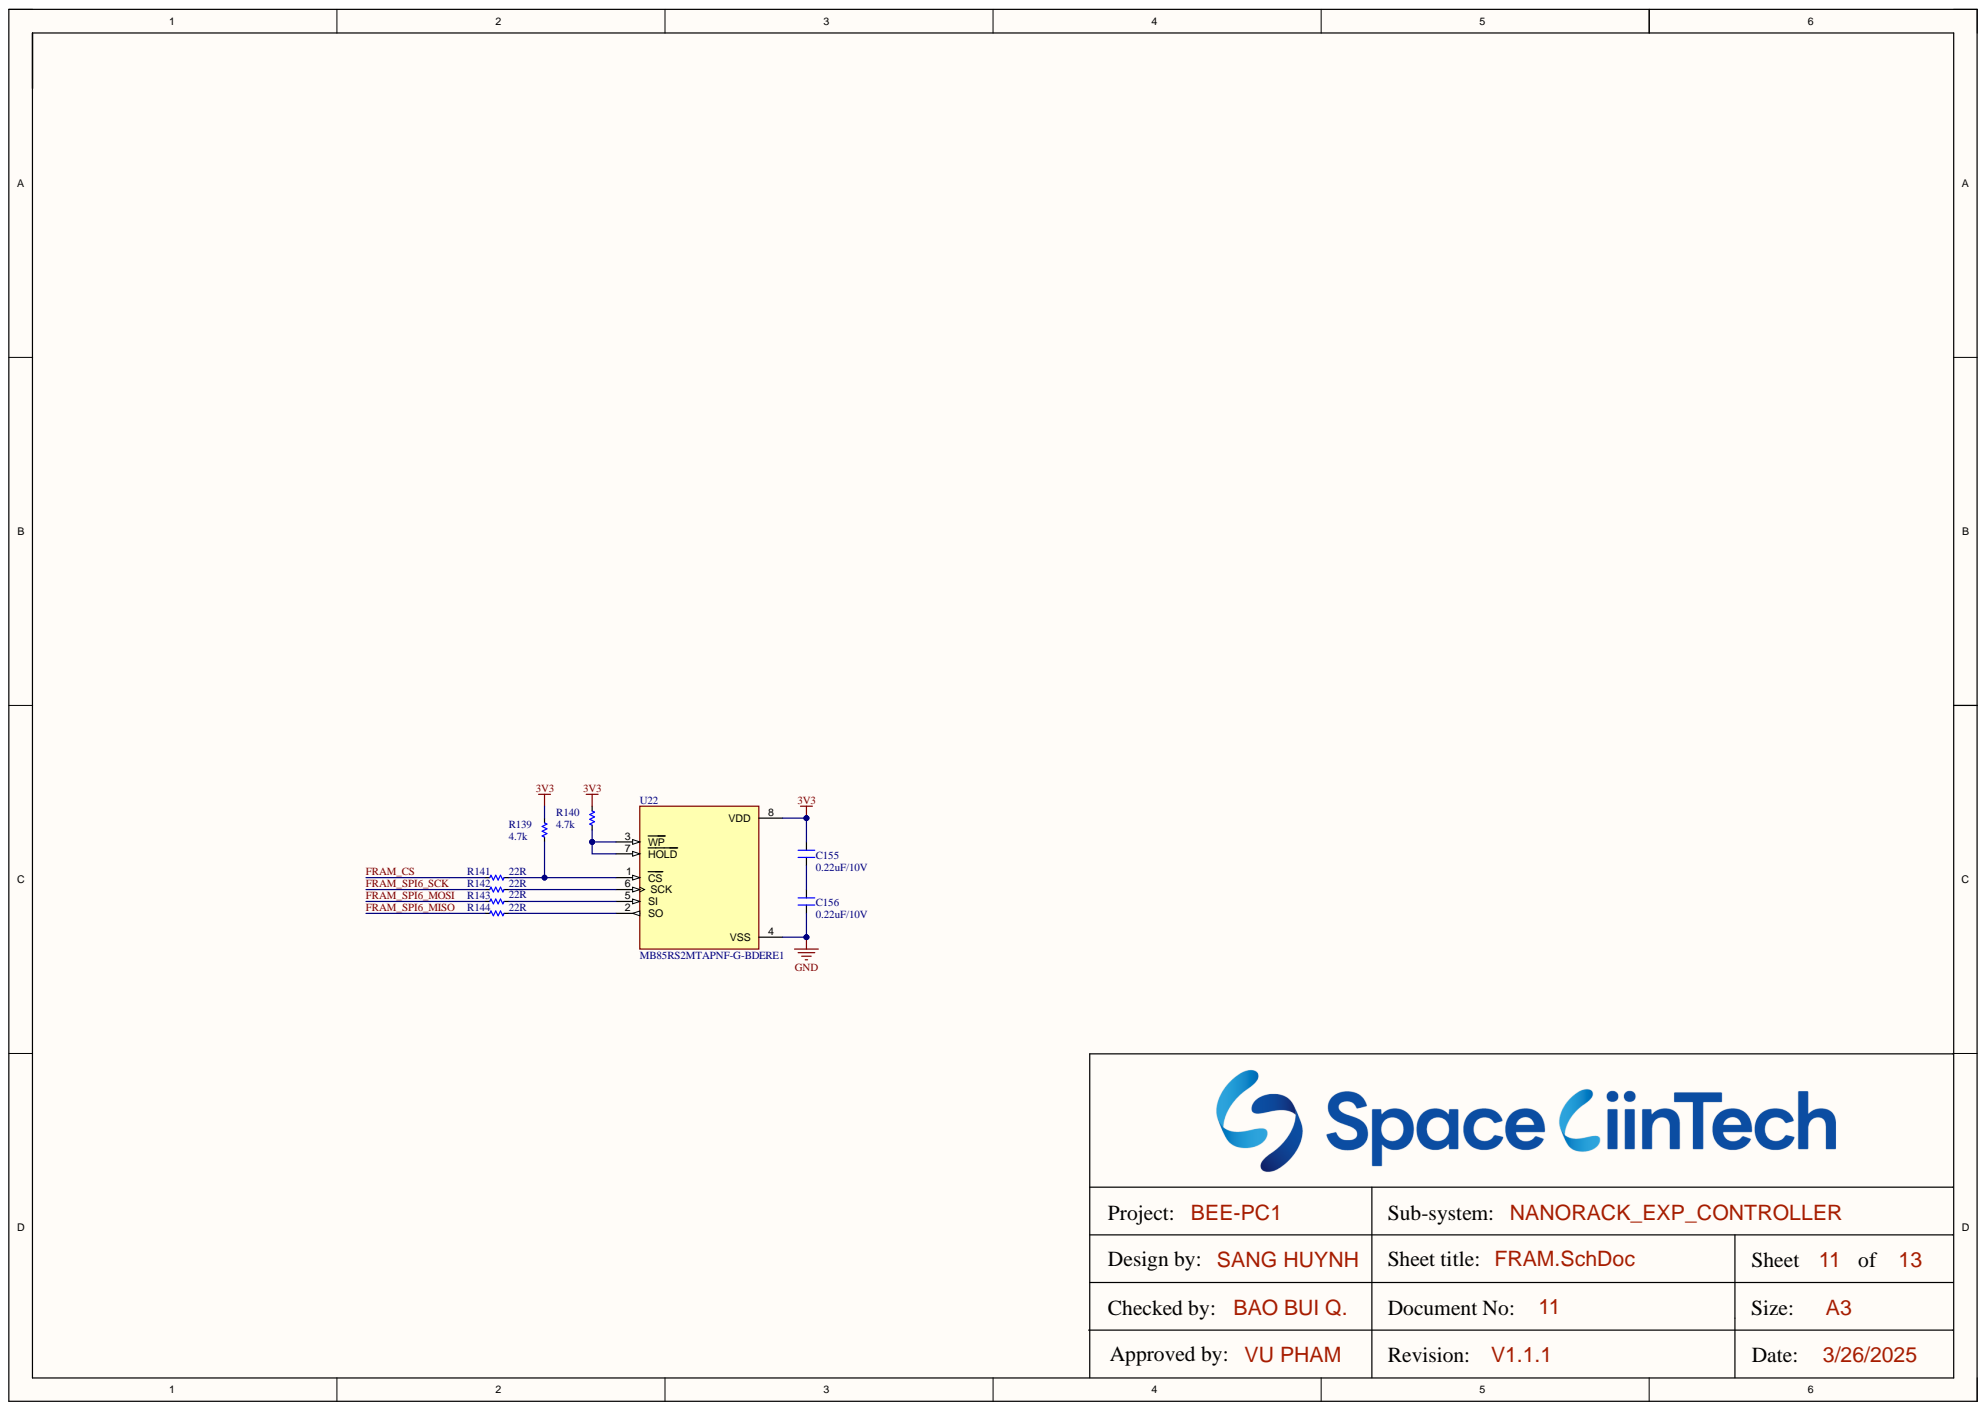
[picture p11: page 11]

Project : BEE-PC1 | Sub-system : NANORACK_EXP_CONTROLLER

Design by: SANG HUYNH | Sheet title: FRAM.SchDoc | Sheet 1 1 of 13

Checked by: BAO BUI Q. | Document No: V1.1.11 1 | Size: A3

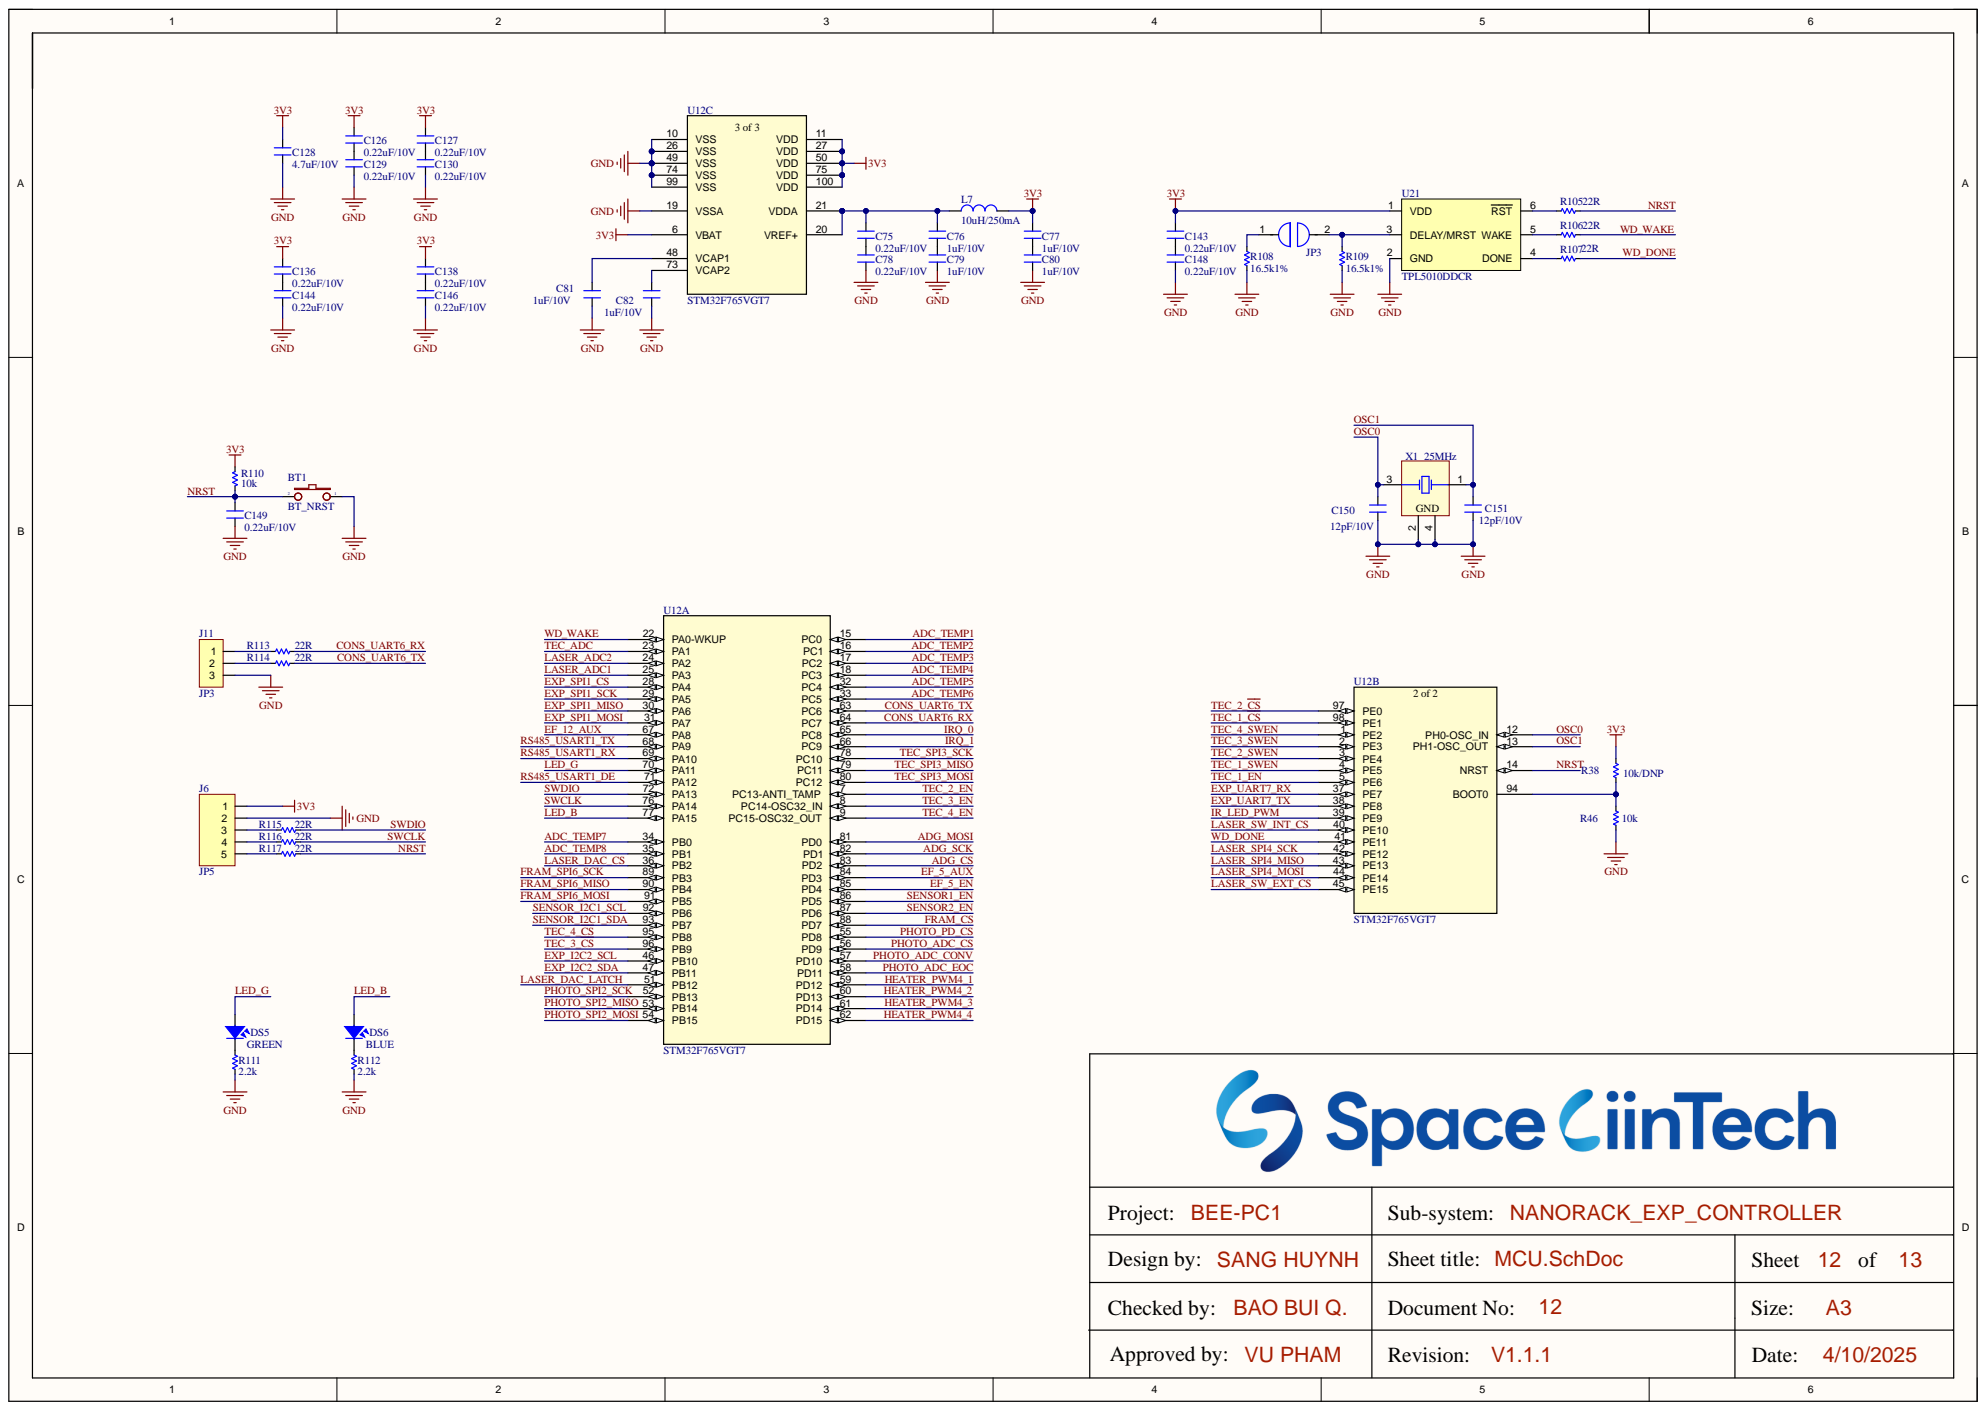
[picture p12: page 12]

VBAT 6 | | DELAY/MRST 3

VCAP2 73

Project: BEE-PC1 | Sub-system: NANORACK_EXP_CONTROLLER

Design by: SANG HUYNH | Sheet title: MCU.SchDoc | Sheet 12 of 13

Checked by: BAO BUI Q. | Document No: 12 | Size: A3

Date: 4/10/2025

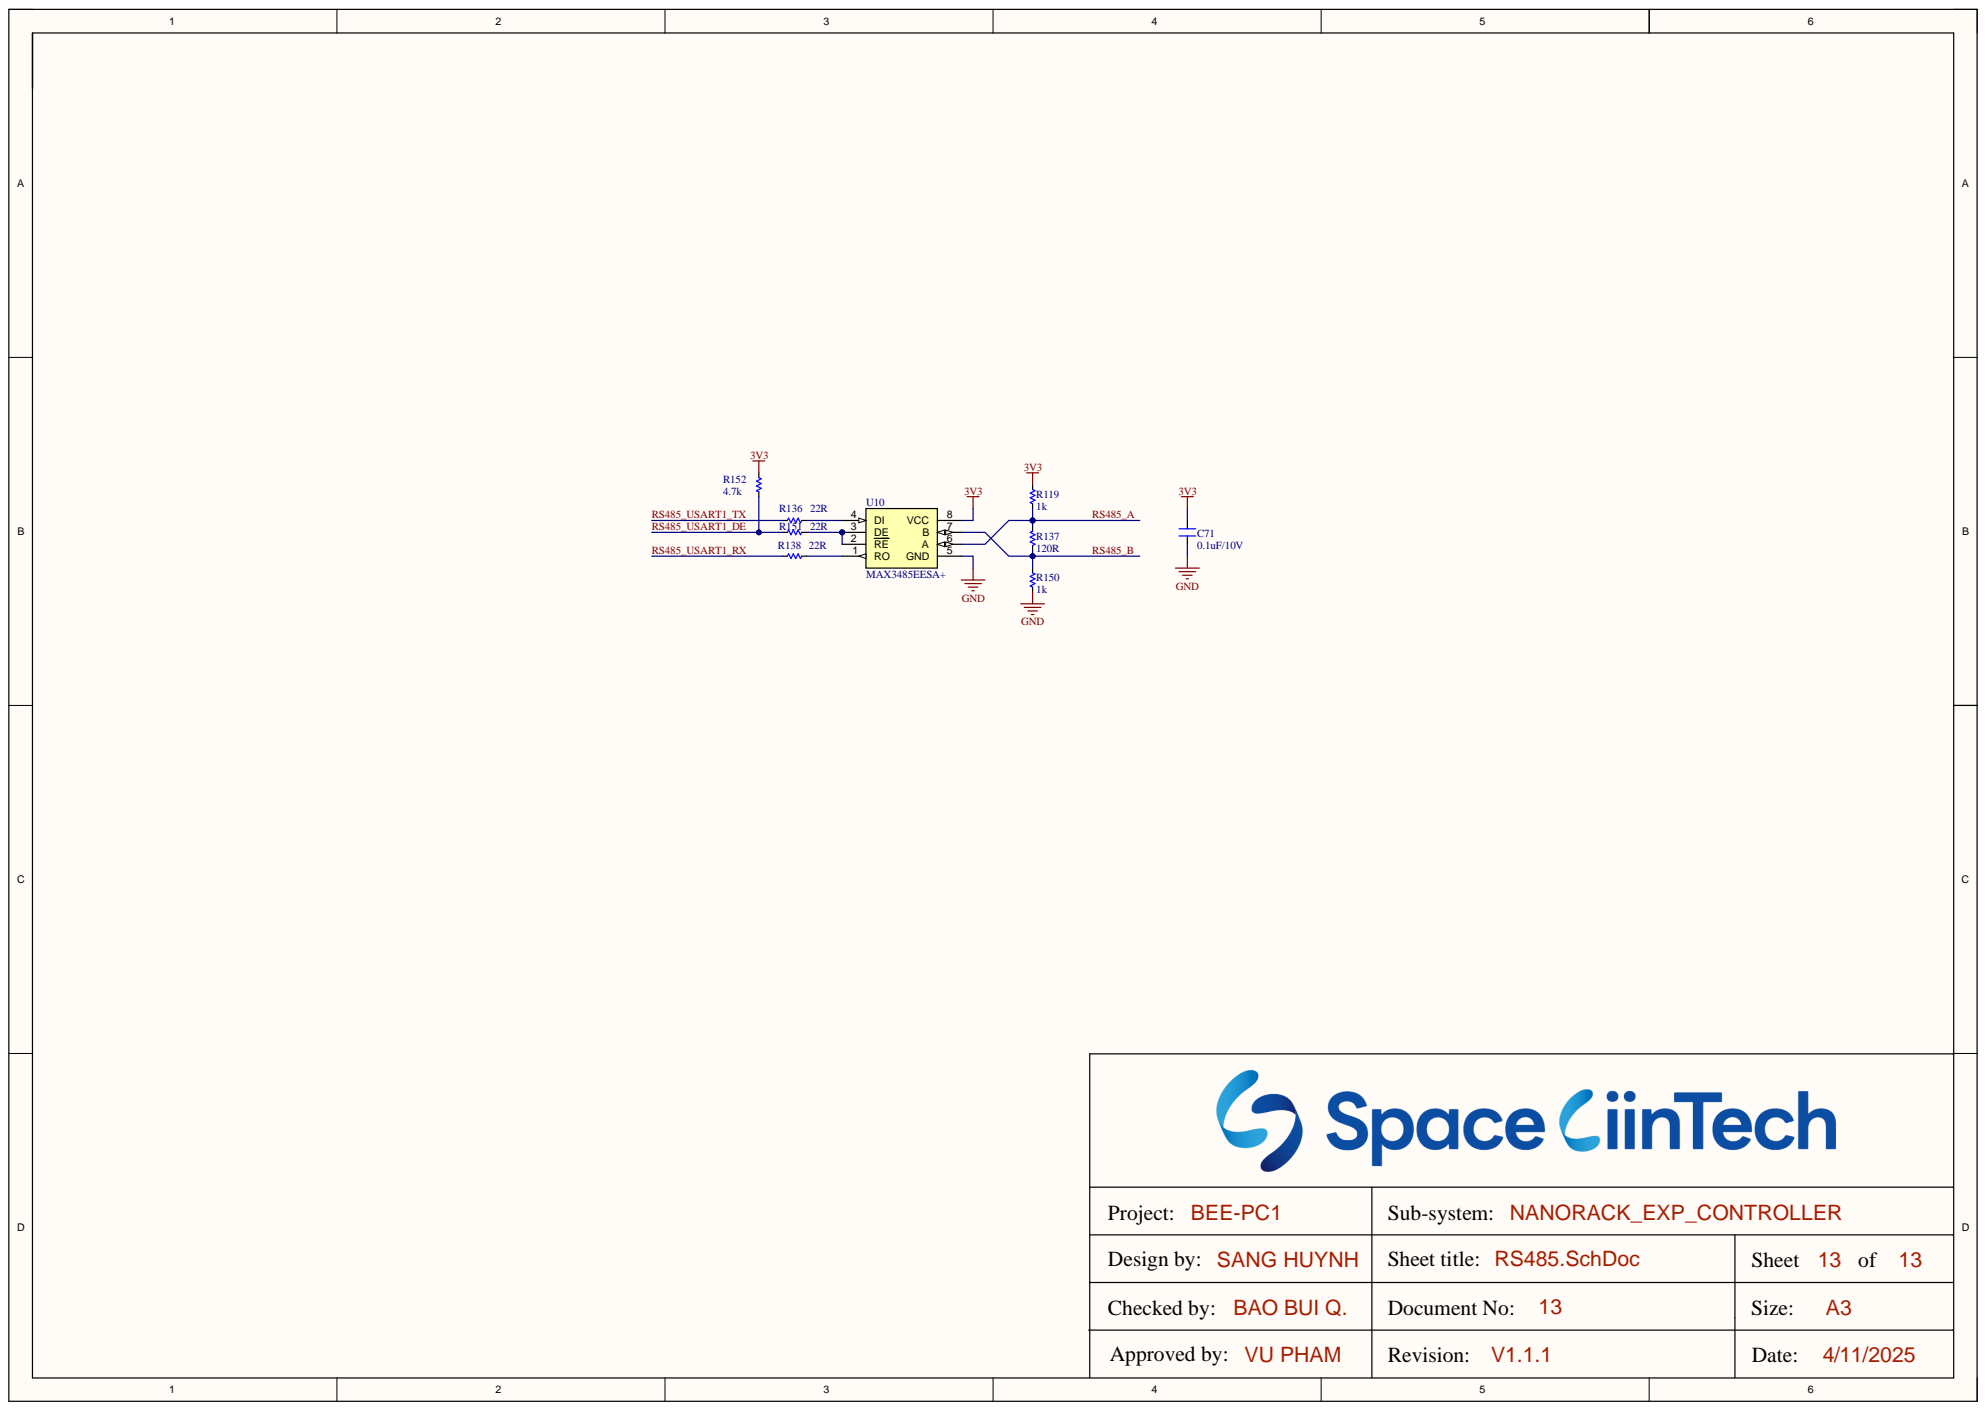
[picture p13: page 13]

Project : BEE-PC1 | Sub-system : NANORACK_EXP_CONTROLLER

Design by: SANG HUYNH | Sheet title: RS485.SchDoc | Sheet 13 of 13

Checked by: BAO BUI Q. | Document No: 13 | Size: A3

Date: 4/11/2025
