baobuibk/NANORACK_V2_EXP_1.1.1_HW/05_SMT/EXP_V120_ASM_FILE.pdf

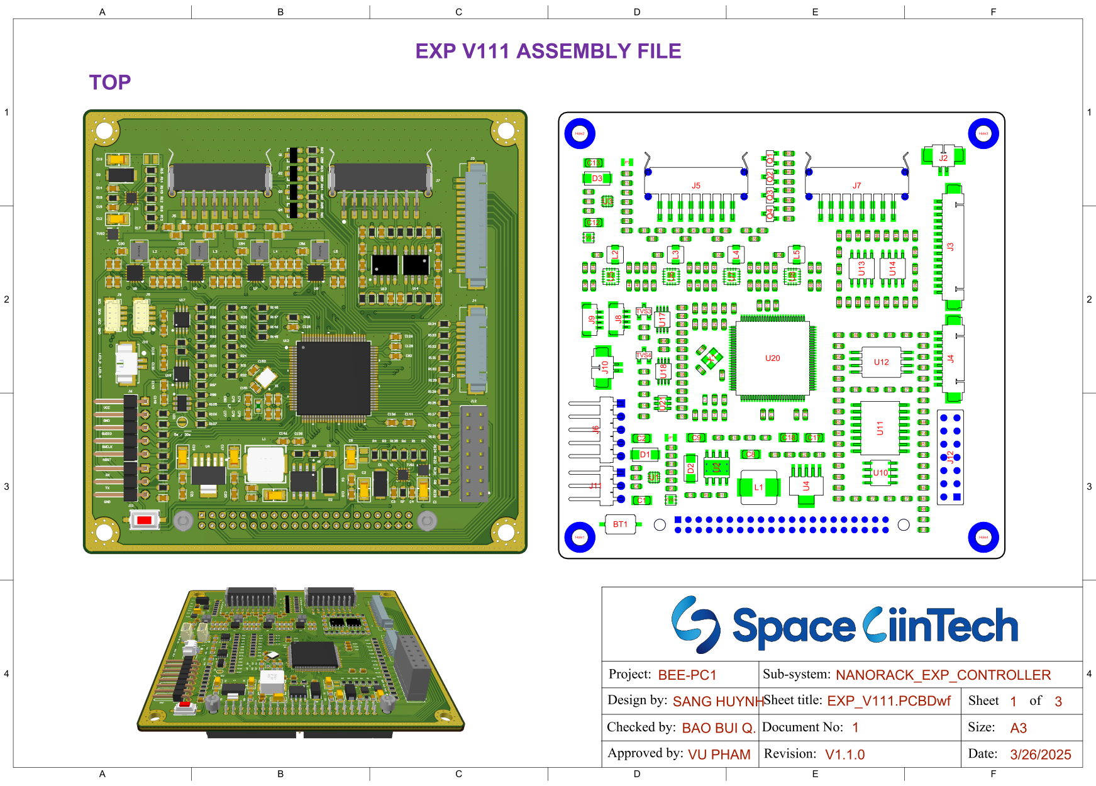
[picture p14: page 1]

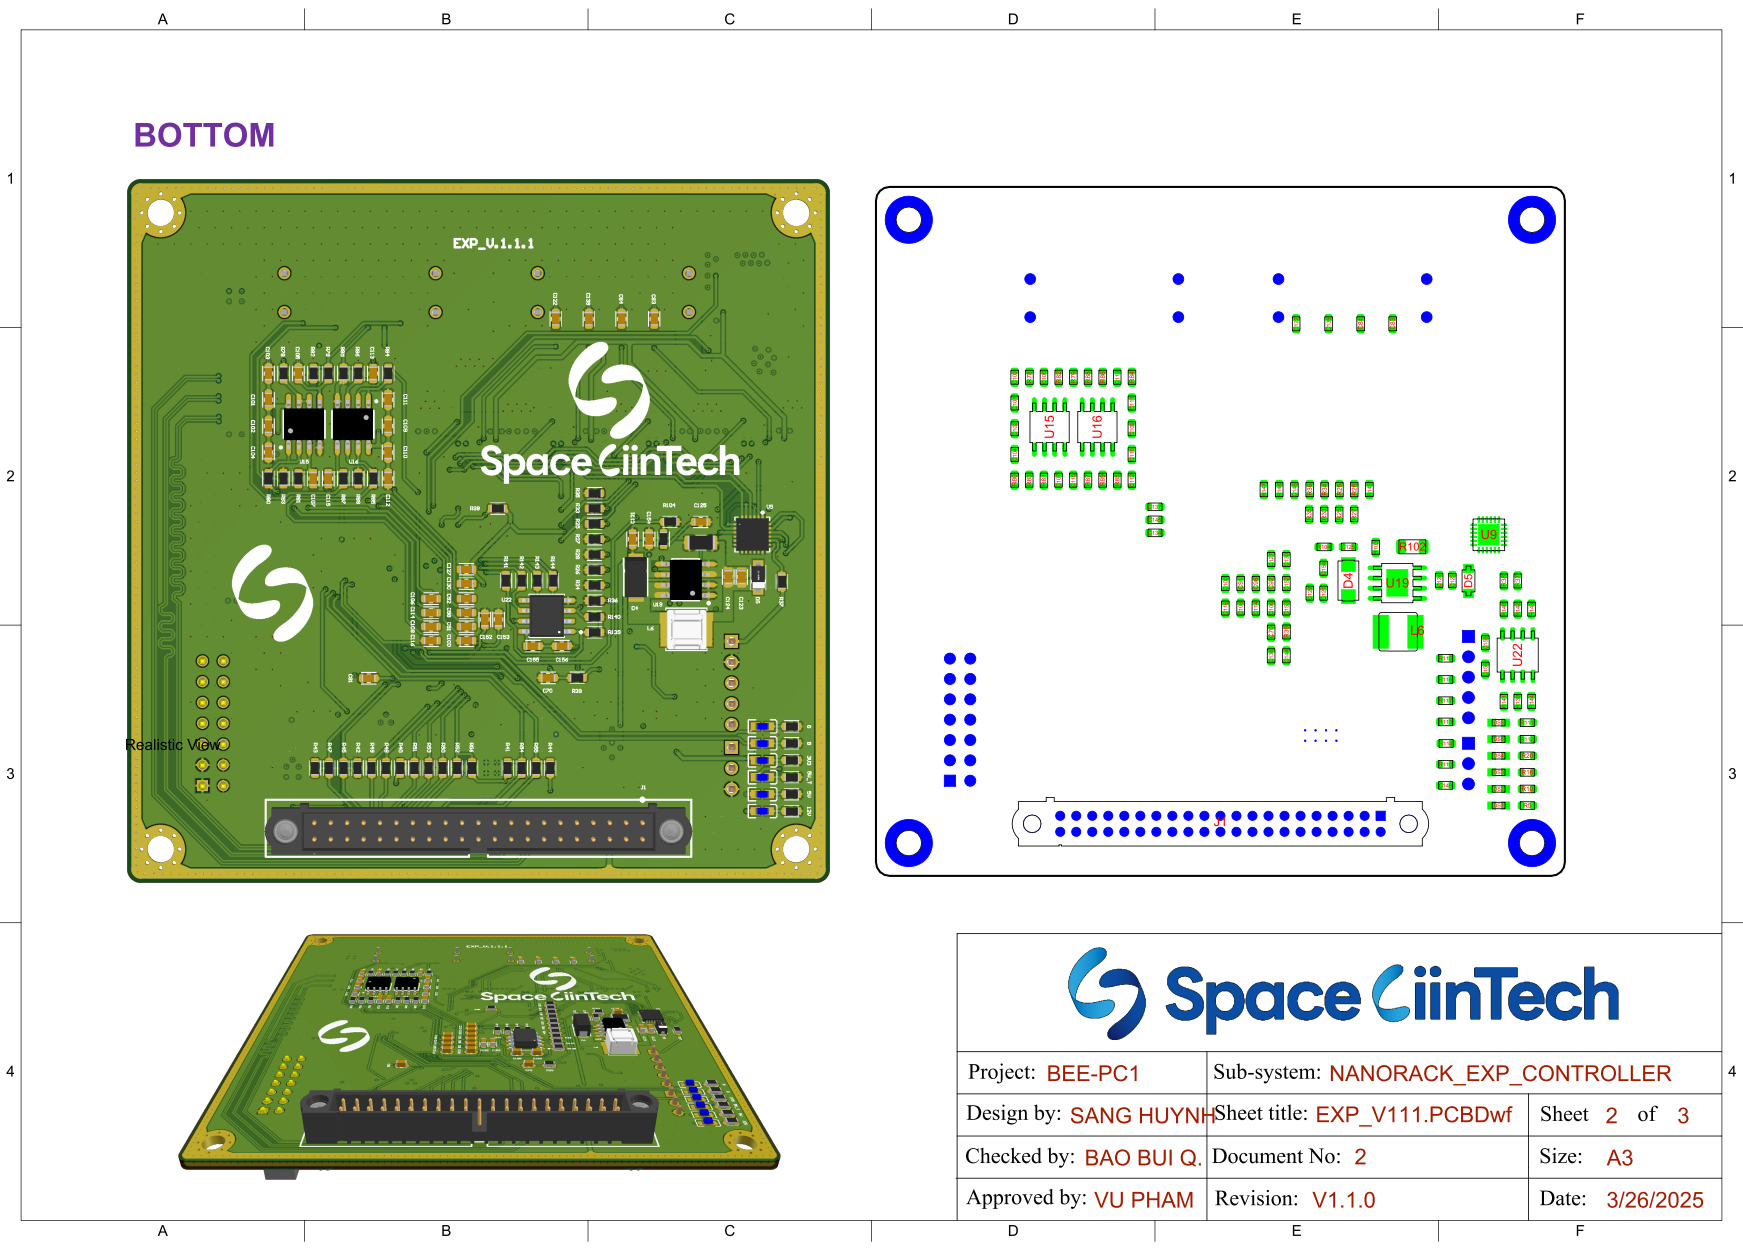
[picture p15: page 2]

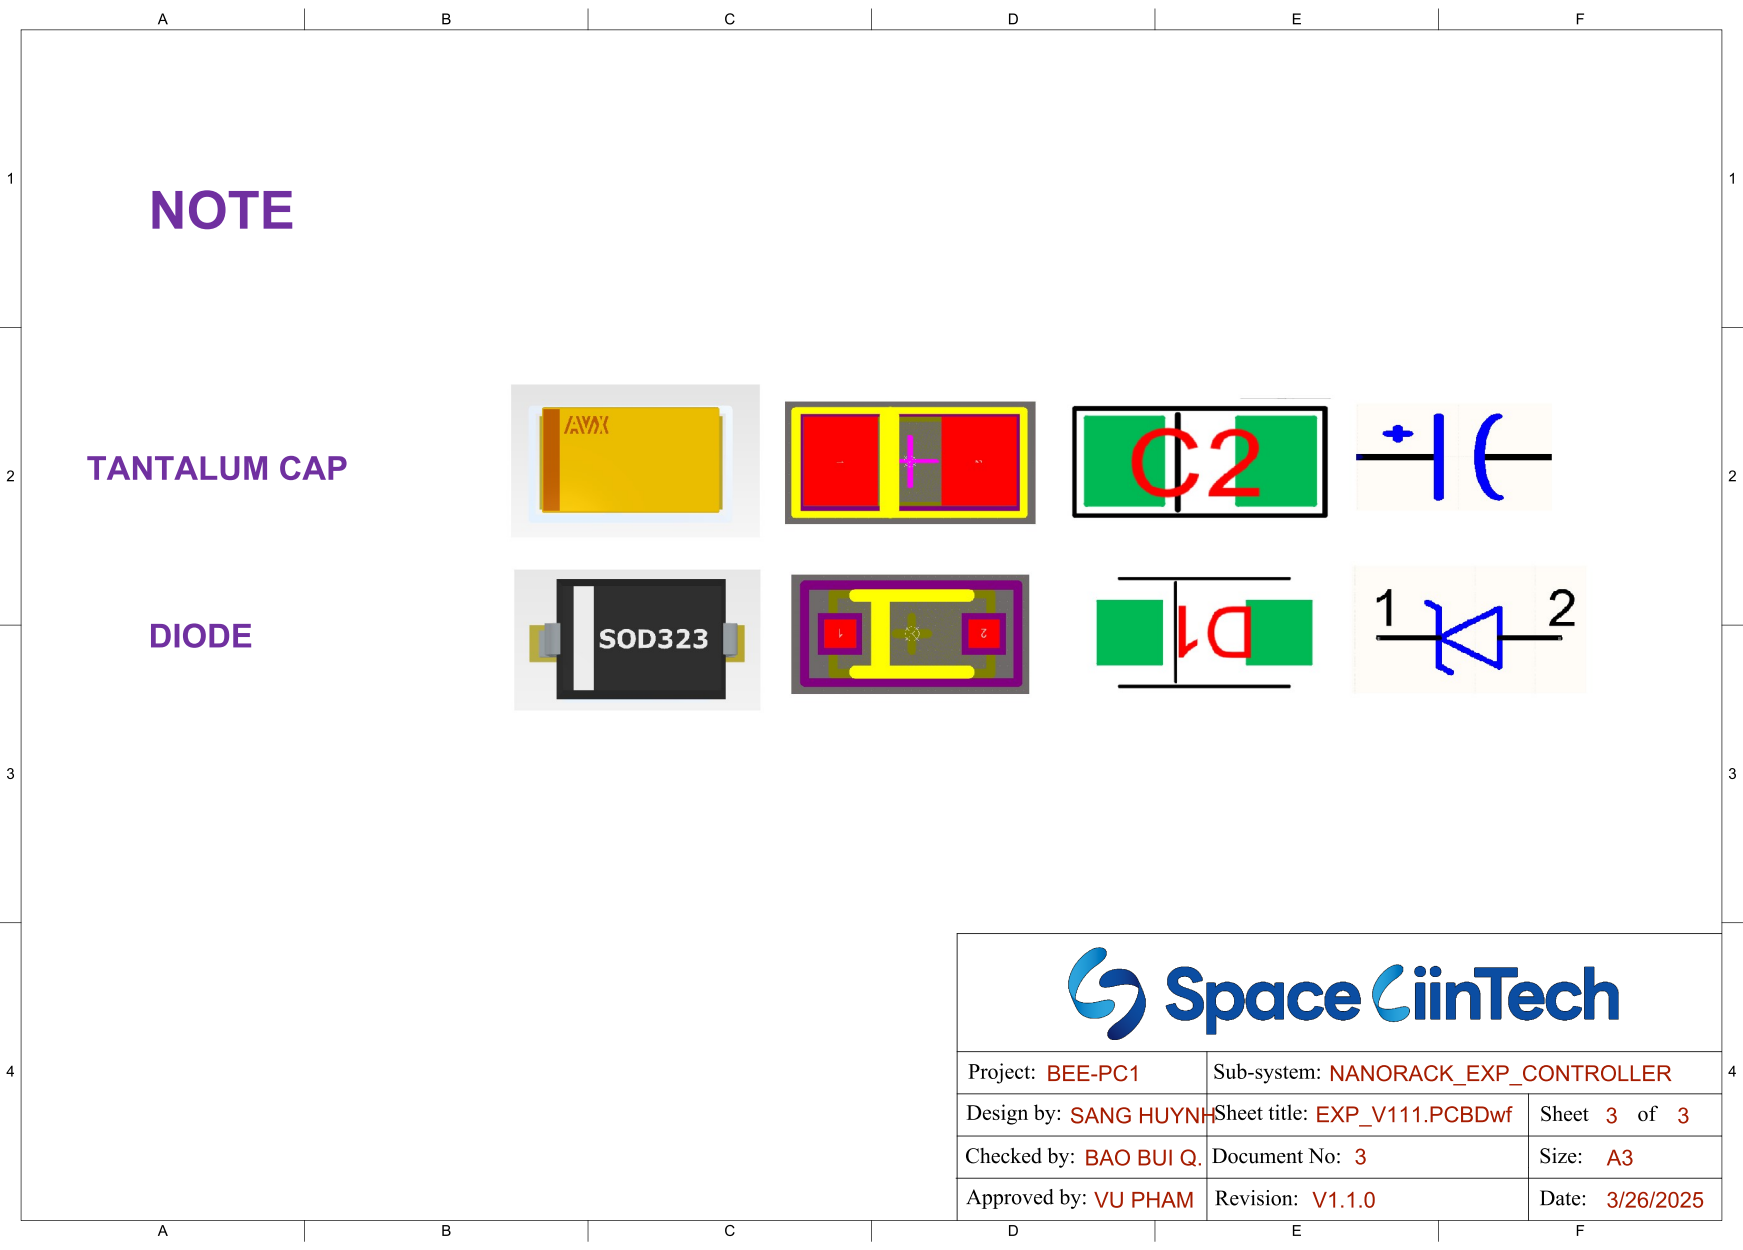
[picture p16: page 3]
