baobuibk/NANORACK_V2_EXP_1.1.1_HW/(commit log)

2025-03-19 EXP_V3 | 19_03_25
    [Block_Diagram.SchDoc, EXP_HW_V3.PrjPcb, EXP_HW_V3.SchLib, EXP_HW_V3_2.SCHLIB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]
2025-03-20 EXP_V3 | 20_03_25
    [EXP_HW_V3_2.SCHLIB, EXP_V2_BOM.xlsx, EXP_V3_BOM.xlsx, HEADER_1.SchDoc, Sang_library.PcbLib]
2025-03-20 EXP_V3 | 20_03_25 | 23:35
    [EXP_V3_BOM.xlsx, HEADER_1.SchDoc, I2C_Sensor.SchDoc, MCU.SchDoc]
2025-03-22 EXP_V3 | 23_03_25 | 02:27
    [MCU.SchDoc]
2025-03-23 EXP_V3 | 24_03_25 | 00:33
    [MCU.SchDoc, POWER.SchDoc]
2025-03-24 EXP_V3 | 24_03_25 | 14:38
    [HEADER_1.SchDoc, HEADER_2.SchDoc, MCU.SchDoc, POWER.SchDoc]
2025-03-24 EXP_V3 | 24_03_25 | 16:07 | DONE PCB
    [EXP_HW_V3.PrjPcb, MCU.SchDoc, POWER.SchDoc]
2025-03-24 EXP_V3 | 24_03_25 | 23:53
    [EXP_HW_V3.PrjPcb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]
2025-03-25 EXP_V3 | 25_03_25 | 10:45
    [EXP_HW_V3.PrjPcb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]
2025-03-25 EXP_V3 | 25_03_25 | 14:11
    [EXP_V3_BOM.xlsx]
2025-03-25 EXP_V3 | 25_03_25 | 20:30
    [EXP_V111.GBL, EXP_V111.GBO, EXP_V111.GBP, EXP_V111.GBS, EXP_V111.GKO, EXP_V111.GTL, EXP_V111.GTO, EXP_V111.GTP]
2025-03-26 EXP_V3 | 26_03_25 | 12:54
    [EXP_HW_V3.PrjPcb, EXP_HW_V3.SchLib, EXP_V110.xls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]
2025-03-26 EXP_V3 | 26_03_25 | 16:07
    [Block_Diagram.SchDoc, EXP_HW_V3.PrjPcb, FRAM.SchDoc, HEADER_1.SchDoc, HEADER_2.SchDoc, HEATER.SchDoc, History.SchDoc, I2C_Sensor.SchDoc]
2025-03-27 EXP_V3 | 27_03_25 | 23:48
    [EXP_HW_V3.PrjPcb, EXP_HW_V3.SchLib, EXP_V110.xls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]
2025-03-27 EXP_V3 | 27_03_25 | 23:49
    [EXP_V110.xls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]
2025-04-08 change name (V111 -> V120)
    [EXP_V111.GBL, EXP_V111.GBO, EXP_V111.GBP, EXP_V111.GBS, EXP_V111.GKO, EXP_V111.GTL, EXP_V111.GTO, EXP_V111.GTP]
2025-04-08 EXP_V120 | 08_04_25 | 23:38
    [EXP_HW_V3.PrjPcb, EXP_HW_V3.SchLib, EXP_V110.xls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]
2025-04-09 EXP_V120 | 09_04_25 | 20:58
    [EXP_V3_BOM.xlsx]
2025-04-10 EXP_V120 | 10_04_25 | 15:30
    [EXP_HW_V3.PrjPcb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]
2025-04-10 EXP_V120 | 10_04_25 | 22:09
    [EXP_HW_V3.PrjPcb, EXP_HW_V3.SchLib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]
2025-04-10 EXP_V120 | 10_04_25 | 22:24
    [EXP_HW_V3.PrjPcb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]
2025-04-11 EXP_V120 | 11_04_25 | 14:00
    [EXP_HW_V3.PrjPcb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]
2025-04-14 EXP_V120 | 14_04_25 | 9:15
    [EXP_V3_BOM.xlsx, HEADER_1.SchDoc]
